adrianntz/gpstracker/Host Software/Host Website/assets/img/demo-image-01.png

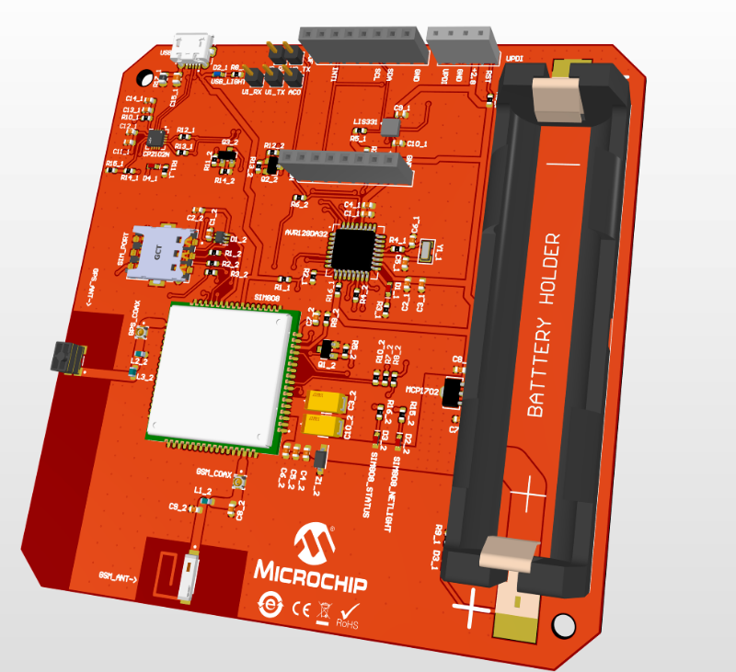
Host Software/Host Website/assets/img/demo-image-01.png
