adrianntz/gpstracker/Hardware/Readme.md

# Power Efficient GPS Tracker HW Design



This is an internship project aiming to build a portable GPS Tracker which sends out its GPS coordinates whenever it detects motion either through SMS or to a website application through power efficient means.
## Folders
- Design - Files for the Altium PCB Project for the GPS Tracker. Contains schematics, PCBDocs, Project output files.
- Manufacturing - Manufacturing files for PCB Factory.

## 3D View
### MCU+ACCEL SCHEMATIC
MCU+ACCEL SCHEMATIC
### SIM808 + RF SCHEMATIC

### TOP VIEW

### Bottom View

## Components used
````
1 AVR128DA32  
1 SIM808
1 MCP1702T
1 LIS331DLHTR
1 CP2102N 
1 MicroUSB
1 Li-Ion 2200mAh 3.6V 
1 Battery Holder

4 Red LED 0603 
1 Blue LED 0603
1 Green LED 0603 

6 R 4.7k 0603
3 R 47k 0603
1 R 47.5k 0603
2 R 5.6k 0603
5 R 0ohm 0603
8 R 220R 0603 
3 R 22R 0603
1 R 220k 0603
1 R 470k 0603
1 R 22.1k 0603
1 R 1k 0603
1 R 1M 0603 

6 Cap 0.1uF 0603
4 Cap 1uF 0603 
3 Cap 4.7uF 0603 
1 Cap 2.2uF 0603
1 Cap 10uF 0603
2 Cap 100uF Tantulum
1 Cap 22pF 0603
1 Cap 33pF 0603
1 Cap 13pF 0603
1 Cap 3.9pF 0603
2 Cap 10pF 0603
1 Cap 0.3pF 0603
1 Cap 100pF 0603

2 Ind 18nH 0603
1 Ind 5.1nH 0603 

3 MOSFET SOT-23-3

1 Zener 5.1V SOD-123

1 TVS Diode Array 5 channel

1 Nano SIM card holder

1 GSM Antenna
1 GPS Antenna 
2 Coaxial SMD Connectors 

````
