adrianntz/gpstracker/Firmware/Prototype Firmware/GPS_TRACKER_SW_architecture.png

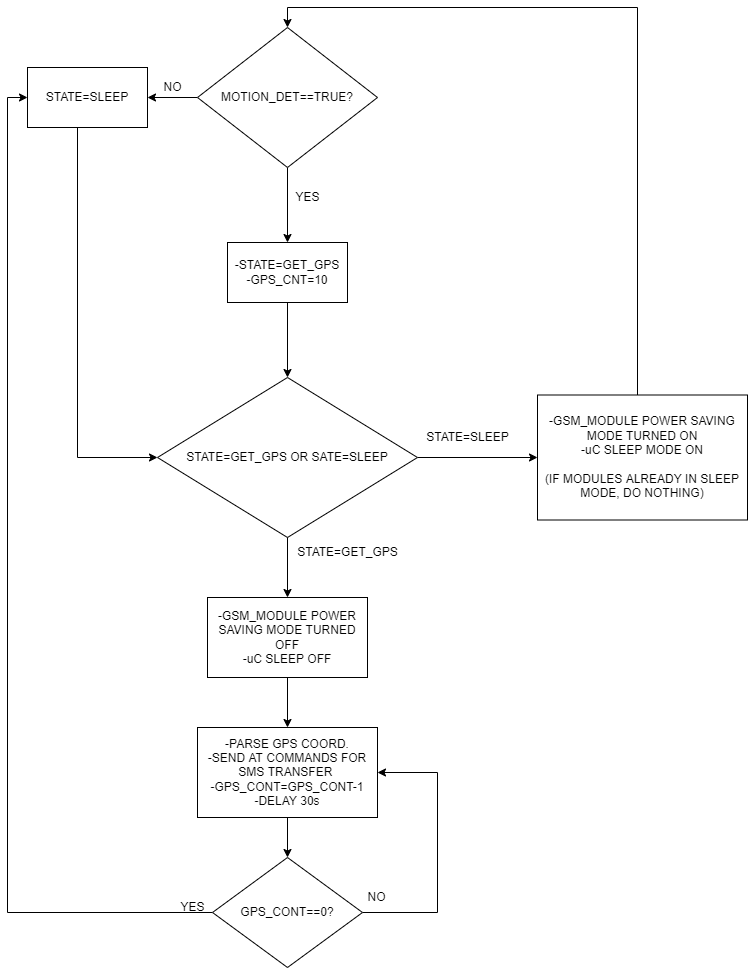
Firmware/Prototype Firmware/GPS_TRACKER_SW_architecture.png
