adrianntz/gpstracker/Hardware/GPS_TRACKER_HW_PROTOTYPE.png

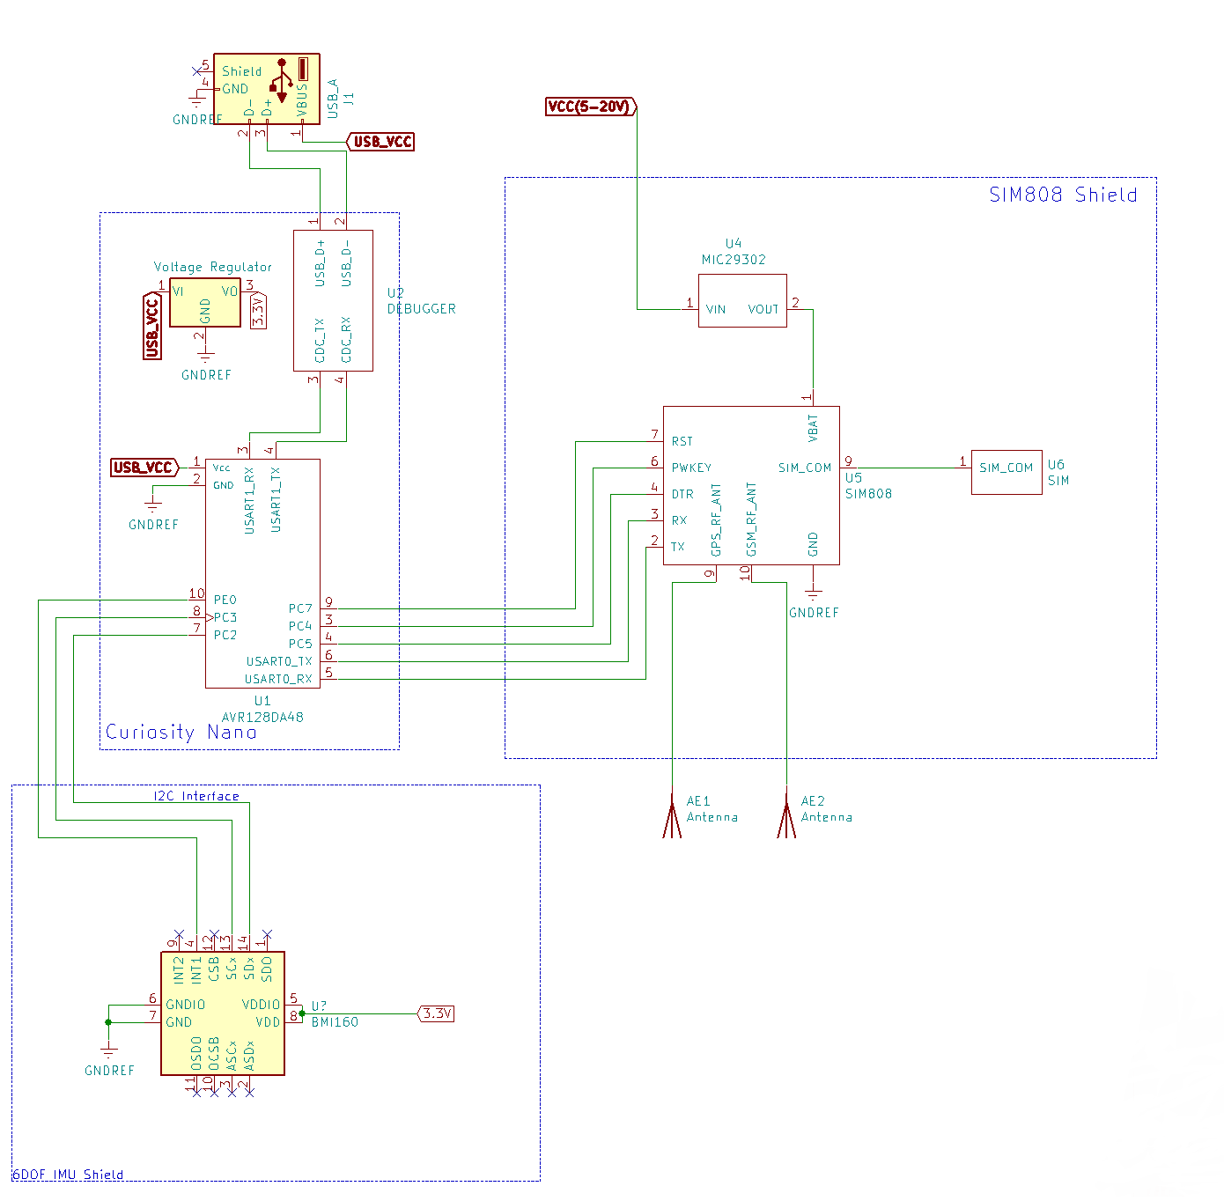
Hardware/GPS_TRACKER_HW_PROTOTYPE.png
