adrianntz/gpstracker/Host Software/Host Website/assets/img/demo-image-02.png

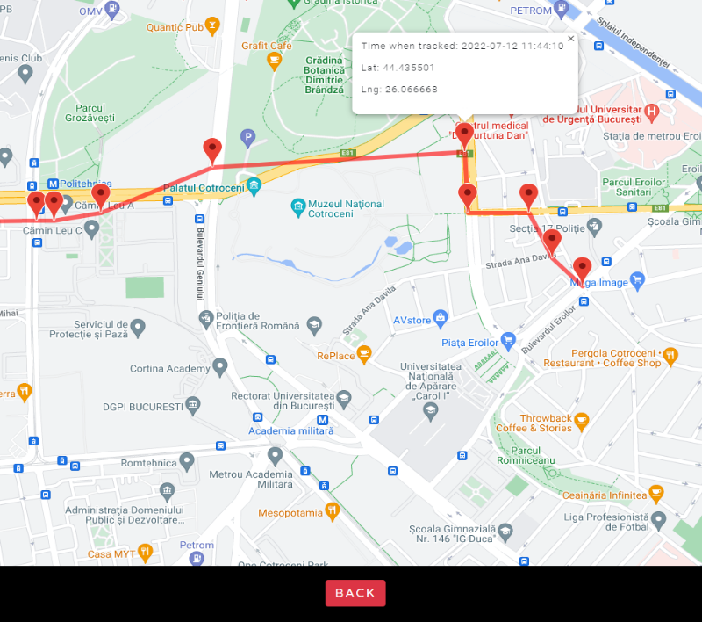
Host Software/Host Website/assets/img/demo-image-02.png
