adrianntz/gpstracker/Hardware/Design/Project Outputs for GPS_TRACKER/GPS_TRACKER_BOM.xlsx

Name | Description | Designator | Value | Quantity | Cantiate Cumparata
Transistor MOS-N GSD | Transistor MOS | Q1_2, Q2_2, Q3_2 | 2N7002-7-F | 3 | 30 | G
TAJC107K010RNJ | 100uF 10V ±10% 1.2Ω 2312 SMD Tantalum Capacitor | C3_2 | 100uF | 1 | 10 | G
SMF05CT1G | 5-Line Transient Voltage Suppressor Array, 6-Pin SC70, Pb-Free, Tape and Reel | U1_2 |  | 1 | 10 | G
SIM8051-6-0-14-01-A | NANO SIM PUSH PULL, 6P, SMT, 1.3 | J1_2 |  | 1 | 10 | G
Resistor | Resistor | R1_1 | 220k | 1 | 10 | G
Resistor | Resistor | R1_2, R2_2, R3_2 | 22R | 3 | 30 | G
Resistor | Resistor | R2_1 | 470k | 1 | 10 | G
Resistor | Resistor | R3_1, R8_1, R9_1, R11_1, R12_1, R13_1, R15_2, R16_2 | 220R | 8 | 80 | G
Resistor | Resistor | R4_1, R6_2, R7_2, R8_2 | 0R | 4 | 40 | G
Resistor | Resistor | R4_2, R11_2, R12_2,R5_1, R6_1, R7_1 | 4.7k | 6 | 60 | G
Resistor | Resistor | R5_2, R13_2, R14_2 | 47k | 3 | 30 | G
Resistor | Resistor | R9_2, R10_2 | 5.6k | 2 | 20 | G
Resistor | Resistor | R10_1 | 1k | 1 | 10 | G
MM8030-2610RJ3 | CONN SWG RCPT STR 50 OHM SMD | J2_2, J3_2 |  | 2 | 20 | G
MCP170X SOT-89-3_TO-92-3 | LDO | U3_1 | MCP1702/2.8V | 1 | 10 | G
LQW15AN5N9C10D | Wire Wound RF Inductor 5.9nH ±0.2nH 760mA 0.056Ω 0402 (1005) | L3_2 | 5.9nH | 1 | 10 | G
LIS331DLHTR | MEMS motion sensor: Ultra low power high performance 3-axis nano accelerometer, -40 to +85°C, LGA-16 (3x3x1), Tape and Reel | U4_1 |  | 1 | 10 | G
LED_red | LED | D1_1, D2_2, D3_2, D4_1 | RED | 4 | 40 | G
LED_green_true | LED TRUE GREEN | D3_1 |  | 1 | 10 | G
LED_blue | LED | D2_1 | BLUE | 1 | 10 | G
Inductor | Inductor | L1_2, L2_2 | 18nH | 2 | 20 | G
Header 1x8 | Header 1x8 | J3_1, J4_1 | HDR-1.27 Female 1x8 | 2 | 20
Header 1x4 |  | J2_1 | HDR-2.54 Female 1x4 | 1 | 10
GSM808 | Integrated Circuit | IC1_2 |  | 1 | 10 | G
Diode Zener |  | D1_2 | 5.1V | 1 | 10 | G
Crystal 2 Pins | Crystal | Y1_1 | 32.768KHZ | 1 | 10 | G
CP2102N-A02-GQFN20 | IC USB TO UART BRIDGE QFN20 | U5_1 |  | 1 | 10 | G
Capacitor NP |  | C1_1 | 2.2uF | 1 | 10 | G
Capacitor NP |  | C1_2 | 22pF | 1 | 10 | G
Capacitor NP |  | C2_1, C3_1, C4_1, C10_1, C12_1, C14_1 | 0.1uF | 6 | 60 | G
Capacitor NP |  | C2_2, C4_2, C7_1, C8_1 | 1uF | 4 | 40 | G
Capacitor NP |  | C5_1,C6_2 | 10pF | 2 | 20 | G
Capacitor NP |  | C5_2 | 33pF | 1 | 10 | G
Capacitor NP |  | C6_1 | 13pF | 1 | 10 | G
Capacitor NP |  | C7_2, C11_1, C13_1 | 4.7uF | 3 | 30 | G
Capacitor NP |  | C8_2 | 3.9pF | 1 | 10 | G
Capacitor NP |  | C9_1 | 10uF | 1 | 10 | G
Capacitor NP |  | C9_2 | 0.3pF | 1 | 10 | G
Battery Holder - 1042 | Undefined or Miscellaneous | U1_1 |  | 1 | 10 | G
AVR64DD32-I/PT |  | U2_1 | AVR64DD32 | 1 | 10 | G
1462350001 | RF ANT 1.575GHZ MOLDED SLDR SMD | ANT2_2 |  | 1 | 10 | G
105017-0001 | Micro-USB B Receptacle, Right Angle, Bottom Mount, Surface Mount, with Solder Tabs, -30 to 85 degC, 5-Pin USB, RoHS, Tape and Reel | J1_1 |  | 1 | 10 | G
0900AT43A0070E | RF ANT CHIP SOLDER SMD | ANT1_2 |  | 1 | 10 | G
