adrianntz/gpstracker/Hardware/Design/Project_Outputs/DevTools/ProjectPartNumber-RProjectRevisionSCH_FRM-50207.xlsx

Sheet: Revision History
Product Compliance Data Collection Tool
REV | DATE | CN # | ORIGINATOR | DESCRIPTION OF CHANGE
A | 2019-07-12 | FRM032985 | M.Wittel | Initial Release
B | 2020-12-11 | FRM049453 | B. Yncera | Name change of the "Compliance Review" worksheet to Development Boards_Modules. Addition of Product Compliance Description Worksheet Worksheet update to create more uniformity between the worksheets "SIP discrete components" and "Development Boards_Modules". Changes include: Cell text change J-Q Row 2 - "SIP discrete components" and "Development Boards_Modules" - "Product Compliance will complete" to "Product Compliance" (Vendor Part Number) columns "SIP discrete components" and "Development Boards_Modules" worksheets Removal of Column headers Pkg Size, Value 1, Value Tol, Value Uom 1, Value 2, Value Uom 2, RoHS 3 (Yes/No), from "SIP discrete components" and "Development Boards_Modules" worksheets Column header name change - REACH (SVHC) (Yes/No) 191 to REACH Conformant (Yes/No) "SIP discrete components" worksheet Column header name change - REACH (SVHC) (Yes/No) 197 to REACH Conformant (Yes/No) "Development Boards_Modules" worksheet. Addition of Column header - China RoHS (Affected/Unaffected) - "SIP discrete components" worksheet Column header name change - China RoHS Table Declaration Required (Yes/No) to China RoHS (Affected/Unaffected) "Development Boards_Modules" worksheet.
Electronic Distribution: SPS_16A, SPS_B, SPS_19
THIS DOCUMENT IS UNCONTROLLED UNLESS OTHERWISE STAMPED. It is the user’s responsibility to ensure this is the latest revision prior to using or referencing this document. |  |  |  |  | Page | Spec. No. | Rev.
© Microchip Technology Inc. |  |  |  |  | 1 | FRM-50207 | B

Sheet: Description
 | Any Worksheet within this spreadsheet can be modified as needed to collect information
 | Page quick link | Description
1 | FC LF Package | Single and Multi-Die, Flip Chip Interconnect in Leadframe Package
2 | FC Substrate Package | Single and Multi-Die, Flip Chip Interconnect in Substrate Package
3 | Hybrid LF Package | Multi-Die, Flip Chip and WB Interconnect in Leadframe Package
4 | Hybrid Substrate Package | Multi-Die, Flip Chip and WB Interconnect in Substrate Package
5 | WB LF Package | Single and Multi-Die, WB Interconnect in Leadframe Package
6 | WB Substrate Package | Single and Multi-Die, WB Interconnect in Substrate Package
7 | WLCSP | Wafer Level CSP
8 | SiP | Single and Multi-Die, Flip Chip or WB Interconnect with Passives/Active Components
9 | SIP discrete components | SIP discrete components Compliance Review
10 | MCD Example | MCD Example
11 | MCD Input Form | MCD Input Form
 | Development Boards_Modules | All Module or Board Level Compliance Review
12 | Product Compliance Description | Product Compliance Column Description
 | Note: If there are additional items (e.g. die conformal coat materials or more than one die attach materials), insert rows as required.

Sheet: FC LF Package
Assembly location:
Total Assembled weight: |  | Enter Value | Estimated Homogenous material weight (mg) | RoHS Test Report or CoC | MSDS Report or 100% MCD | Halogen-Free: IEC 61249-2-21:2003: Bromine (Br) ≤ 900 and Chlorine (Cl) ≤ 900 ppm by homogeneous material weight. With total Bromine (Br) plus Chlorine (Cl) content ≤ 1500 ppm by homogeneous material weight. (ICP) | EU REACH Report all SVHC
Molding Compound | Type/ Brand Name: | Enter Value | Enter Value | Attach Supporting Documentation / Insert Object | Attach Supporting Documentation / Insert Object | Attach Supporting Documentation / Insert Object | Attach Supporting Documentation / Insert Object / for all SVHC
 | Supplier | Enter Value
 | Manufacturing Site Location | Enter Value
Underfill | Type/ Brand Name: | Enter Value | Enter Value | Attach Supporting Documentation / Insert Object | Attach Supporting Documentation / Insert Object | Attach Supporting Documentation / Insert Object | Attach Supporting Documentation / Insert Object / for all SVHC
 | Supplier | Enter Value
 | Manufacturing Site Location | Enter Value
Lead frame information | Material Type/Brand Name: | Enter Value | Enter Value | Attach Supporting Documentation / Insert Object | Attach Supporting Documentation / Insert Object | N/A | Attach Supporting Documentation / Insert Object
 | Supplier | Enter Value
 | Manufacturing Site Location | Enter Value
 | Paddle Size | Enter Value
 | Part number | Enter Value
 | Process (Stamped / Etched) | Enter Value
 | Surface | Enter Value
 | Leadlock (Yes / No) | Enter Value
Flux | Type/ Brand Name: | Enter Value | Enter Value | Attach Supporting Documentation / Insert Object | Attach Supporting Documentation / Insert Object | Attach Supporting Documentation / Insert Object | Attach Supporting Documentation / Insert Object / for all SVHC
 | Supplier | Enter Value
 | Manufacturing Site Location | Enter Value
Plated Bump/Copper Pillar | Type/ Brand Name: | Enter Value | Enter Value | Attach Supporting Documentation / Insert Object | Attach Supporting Documentation / Insert Object | N/A | Attach Supporting Documentation / Insert Object / for all SVHC
 | Supplier: | Enter Value
 | Manufacturing Site Location | Enter Value
Die/Wafer Type | Type/ Brand Name: | Enter Value | Enter Value | Attach Supporting Documentation / Insert Object / SGS Test Report | Attach Supporting Documentation / Insert Object | N/A | Attach Supporting Documentation / Insert Object
 | Supplier: | Enter Value
 | Part number | Enter Value
 | Manufacturing Site Location | Enter Value
Plating Line Environmental Compliance Docs and Impurity Control Chart/Plan
Attach Control Plan or Chart Here | Type of process: | Enter Value | Enter Value | Attach Supporting Documentation / Insert Object | Attach Supporting Documentation / Insert Object | Attach Supporting Documentation / Insert Object | Attach Supporting Documentation / Insert Object
 | Principle Chemcial Supplier: | Enter Value
 | Location | Enter Value
Marking | Material Description | Enter Value | Enter Value | Attach Supporting Documentation / Insert Object | Attach Supporting Documentation / Insert Object | Attach Supporting Documentation / Insert Object | Attach Supporting Documentation / Insert Object / for all SVHC
 | Supplier: | Enter Value
 | Manufacturing Site Location | Enter Value

Sheet: FC Substrate Package
Assembly location:
Total Assembled weight: |  | Enter Value | Estimated Homogenous material weight (mg) | RoHS Test Report or CoC | MSDS Report or 100% MCD | Halogen-Free: IEC 61249-2-21:2003: Bromine (Br) ≤ 900 and Chlorine (Cl) ≤ 900 ppm by homogeneous material weight. With total Bromine (Br) plus Chlorine (Cl) content ≤ 1500 ppm by homogeneous material weight. (ICP) | EU REACH Report all SVHC
Molding Compound | Type/ Brand Name: | Enter Value | Enter Value | Attach Supporting Documentation / Insert Object | Attach Supporting Documentation / Insert Object | Attach Supporting Documentation / Insert Object | Attach Supporting Documentation / Insert Object / for all SVHC
 | Supplier | Enter Value
 | Manufacturing Site Location | Enter Value
Underfill | Type/ Brand Name: | Enter Value | Enter Value | Attach Supporting Documentation / Insert Object | Attach Supporting Documentation / Insert Object | Attach Supporting Documentation / Insert Object | Attach Supporting Documentation / Insert Object / for all SVHC
 | Supplier | Enter Value
 | Manufacturing Site Location | Enter Value
Plated Bump/Copper Pillar | Type/ Brand Name: | Enter Value | Enter Value | Attach Supporting Documentation / Insert Object | Attach Supporting Documentation / Insert Object | N/A | Attach Supporting Documentation / Insert Object / for all SVHC
 | Supplier: | Enter Value
 | Manufacturing Site Location | Enter Value
Substrate | Core Material Type/Brand Name: | Enter Value | Enter Value | Attach Supporting Documentation / Insert Object | Attach Supporting Documentation / Insert Object | N/A | Attach Supporting Documentation / Insert Object
 | Supplier | Enter Value
 | Manufacturing Site Location | Enter Value
 | Pre-preg Material | Enter Value
 | Part number | Enter Value
 | Via Plug Material | Enter Value
 | Soldermask Material | Enter Value
Flux | Type/ Brand Name: | Enter Value | Enter Value | Attach Supporting Documentation / Insert Object | Attach Supporting Documentation / Insert Object | Attach Supporting Documentation / Insert Object | Attach Supporting Documentation / Insert Object / for all SVHC
 | Supplier | Enter Value
 | Manufacturing Site Location | Enter Value
Solder Ball | Type/ Brand Name: | Enter Value | Enter Value | Attach Supporting Documentation / Insert Object | Attach Supporting Documentation / Insert Object | N/A | Attach Supporting Documentation / Insert Object / for all SVHC
 | Supplier: | Enter Value
 | Manufacturing Site Location | Enter Value
Sodler Paste | Type/ Brand Name: | Enter Value | Enter Value | Attach Supporting Documentation / Insert Object | Attach Supporting Documentation / Insert Object | N/A | Attach Supporting Documentation / Insert Object / for all SVHC
 | Supplier: | Enter Value
 | Manufacturing Site Location | Enter Value
Die/Wafer Type | Type/ Brand Name: | Enter Value | Enter Value | Attach Supporting Documentation / Insert Object / SGS Test Report | Attach Supporting Documentation / Insert Object | N/A | Attach Supporting Documentation / Insert Object
 | Supplier: | Enter Value
 | Part number | Enter Value
 | Manufacturing Site Location | Enter Value
Plating Line Environmental Compliance Docs and Impurity Control Chart/Plan
Attach Control Plan or Chart Here | Type of process: | Enter Value | Enter Value | Attach Supporting Documentation / Insert Object | Attach Supporting Documentation / Insert Object | Attach Supporting Documentation / Insert Object | Attach Supporting Documentation / Insert Object
 | Principle Chemcial Supplier: | Enter Value
 | Location | Enter Value
Marking | Material Description | Enter Value | Enter Value | Attach Supporting Documentation / Insert Object | Attach Supporting Documentation / Insert Object | Attach Supporting Documentation / Insert Object | Attach Supporting Documentation / Insert Object / for all SVHC
 | Supplier: | Enter Value
 | Manufacturing Site Location | Enter Value

Sheet: Hybrid LF Package
Assembly location:
Total Assembled weight: |  | Enter Value | Estimated Homogenous material weight (mg) | RoHS Test Report or CoC | MSDS Report or 100% MCD | Halogen-Free: IEC 61249-2-21:2003: Bromine (Br) ≤ 900 and Chlorine (Cl) ≤ 900 ppm by homogeneous material weight. With total Bromine (Br) plus Chlorine (Cl) content ≤ 1500 ppm by homogeneous material weight. (ICP) | EU REACH Report all SVHC
Molding Compound | Type/ Brand Name: | Enter Value | Enter Value | Attach Supporting Documentation / Insert Object | Attach Supporting Documentation / Insert Object | Attach Supporting Documentation / Insert Object | Attach Supporting Documentation / Insert Object / for all SVHC
 | Supplier | Enter Value
 | Manufacturing Site Location | Enter Value
Die Attach Material | Type/ Brand Name: | Enter Value | Enter Value | Attach Supporting Documentation / Insert Object | Attach Supporting Documentation / Insert Object | Attach Supporting Documentation / Insert Object | Attach Supporting Documentation / Insert Object / for all SVHC
 | Supplier | Enter Value
 | Manufacturing Site Location | Enter Value
Underfill | Type/ Brand Name: | Enter Value | Enter Value | Attach Supporting Documentation / Insert Object | Attach Supporting Documentation / Insert Object | Attach Supporting Documentation / Insert Object | Attach Supporting Documentation / Insert Object / for all SVHC
 | Supplier | Enter Value
 | Manufacturing Site Location | Enter Value
LF | Material Type/Brand Name: | Enter Value | Enter Value | Attach Supporting Documentation / Insert Object | Attach Supporting Documentation / Insert Object | N/A | Attach Supporting Documentation / Insert Object
 | Supplier | Enter Value | Enter Value
 | Manufacturing Site Location | Enter Value | Enter Value
 | Paddle Size | Enter Value | Enter Value
 | Part number | Enter Value | Enter Value
 | Process (Stamped / Etched) | Enter Value | Enter Value
 | Surface | Enter Value | Enter Value
 | Leadlock (Yes / No) | Enter Value | Enter Value
Plated Bump/Copper Pillar | Type/ Brand Name: | Enter Value | Enter Value | Attach Supporting Documentation / Insert Object | Attach Supporting Documentation / Insert Object | N/A | Attach Supporting Documentation / Insert Object / for all SVHC
 | Supplier: | Enter Value
 | Manufacturing Site Location | Enter Value
Flux | Type/ Brand Name: | Enter Value | Enter Value | Attach Supporting Documentation / Insert Object | Attach Supporting Documentation / Insert Object | Attach Supporting Documentation / Insert Object | Attach Supporting Documentation / Insert Object / for all SVHC
 | Supplier | Enter Value
 | Manufacturing Site Location | Enter Value
Bond Wire | Type/ Brand Name: | Enter Value | Enter Value | Attach Supporting Documentation / Insert Object | Attach Supporting Documentation / Insert Object | N/A | Attach Supporting Documentation / Insert Object / for all SVHC
 | Supplier: | Enter Value
 | Manufacturing Site Location | Enter Value
Die/Wafer Type | Type/ Brand Name: | Enter Value | Enter Value | Attach Supporting Documentation / Insert Object / SGS Test Report | Attach Supporting Documentation / Insert Object | N/A | Attach Supporting Documentation / Insert Object
 | Supplier: | Enter Value
 | Part number | Enter Value
 | Manufacturing Site Location | Enter Value
Plating Line Environmental Compliance Docs and Impurity Control Chart/Plan
Attach Control Plan or Chart Here | Type of process: | Enter Value | Enter Value | Attach Supporting Documentation / Insert Object | Attach Supporting Documentation / Insert Object | Attach Supporting Documentation / Insert Object | Attach Supporting Documentation / Insert Object
 | Principle Chemcial Supplier: | Enter Value
 | Location | Enter Value
Marking | Material Description | Enter Value | Enter Value | Attach Supporting Documentation / Insert Object | Attach Supporting Documentation / Insert Object | Attach Supporting Documentation / Insert Object | Attach Supporting Documentation / Insert Object / for all SVHC
 | Supplier: | Enter Value
 | Manufacturing Site Location | Enter Value

Sheet: Hybrid Substrate Package
Assembly location:
Total Assembled weight: |  | Enter Value | Estimated Homogenous material weight (mg) | RoHS Test Report or CoC | MSDS Report or 100% MCD | Halogen-Free: IEC 61249-2-21:2003: Bromine (Br) ≤ 900 and Chlorine (Cl) ≤ 900 ppm by homogeneous material weight. With total Bromine (Br) plus Chlorine (Cl) content ≤ 1500 ppm by homogeneous material weight. (ICP) | EU REACH Report all SVHC
Molding Compound | Type/ Brand Name: | Enter Value | Enter Value | Attach Supporting Documentation / Insert Object | Attach Supporting Documentation / Insert Object | Attach Supporting Documentation / Insert Object | Attach Supporting Documentation / Insert Object / for all SVHC
 | Supplier | Enter Value
 | Manufacturing Site Location | Enter Value
Die film/Die attachment | Type/ Brand Name: | Enter Value | Enter Value | Attach Supporting Documentation / Insert Object | Attach Supporting Documentation / Insert Object | Attach Supporting Documentation / Insert Object | Attach Supporting Documentation / Insert Object / for all SVHC
 | Supplier | Enter Value
 | Manufacturing Site Location | Enter Value
Underfill | Type/ Brand Name: | Enter Value | Enter Value | Attach Supporting Documentation / Insert Object | Attach Supporting Documentation / Insert Object | Attach Supporting Documentation / Insert Object | Attach Supporting Documentation / Insert Object / for all SVHC
 | Supplier | Enter Value
 | Manufacturing Site Location | Enter Value
Flux | Type/ Brand Name: | Enter Value | Enter Value | Attach Supporting Documentation / Insert Object | Attach Supporting Documentation / Insert Object | Attach Supporting Documentation / Insert Object | Attach Supporting Documentation / Insert Object / for all SVHC
 | Supplier | Enter Value
 | Manufacturing Site Location | Enter Value
Substrate | Core Material Type/Brand Name: | Enter Value | Enter Value | Attach Supporting Documentation / Insert Object | Attach Supporting Documentation / Insert Object | N/A | Attach Supporting Documentation / Insert Object
 | Supplier | Enter Value
 | Manufacturing Site Location | Enter Value
 | Pre-preg Material | Enter Value
 | Part number | Enter Value
 | Via Plug Material | Enter Value
 | Soldermask Material | Enter Value
Plated Bump/Copper Pillar | Type/ Brand Name: | Enter Value | Enter Value | Attach Supporting Documentation / Insert Object | Attach Supporting Documentation / Insert Object | N/A | Attach Supporting Documentation / Insert Object / for all SVHC
 | Supplier: | Enter Value
 | Manufacturing Site Location | Enter Value
Bond Wire | Type/ Brand Name: | Enter Value | Enter Value | Attach Supporting Documentation / Insert Object | Attach Supporting Documentation / Insert Object | N/A | Attach Supporting Documentation / Insert Object / for all SVHC
 | Supplier: | Enter Value
 | Manufacturing Site Location | Enter Value
Solder Ball | Type/ Brand Name: | Enter Value | Enter Value | Attach Supporting Documentation / Insert Object | Attach Supporting Documentation / Insert Object | N/A | Attach Supporting Documentation / Insert Object / for all SVHC
 | Supplier: | Enter Value
 | Manufacturing Site Location | Enter Value
Sodler Paste | Type/ Brand Name: | Enter Value | Enter Value | Attach Supporting Documentation / Insert Object | Attach Supporting Documentation / Insert Object | N/A | Attach Supporting Documentation / Insert Object / for all SVHC
 | Supplier: | Enter Value
 | Manufacturing Site Location | Enter Value
Die/Wafer Type | Type/ Brand Name: | Enter Value | Enter Value | Attach Supporting Documentation / Insert Object / SGS Test Report | Attach Supporting Documentation / Insert Object | N/A | Attach Supporting Documentation / Insert Object
 | Supplier: | Enter Value
 | Part number | Enter Value
 | Manufacturing Site Location | Enter Value
Plating Line Environmental Compliance Docs and Impurity Control Chart/Plan
Attach Control Plan or Chart Here | Type of process: | Enter Value | Enter Value | Attach Supporting Documentation / Insert Object | Attach Supporting Documentation / Insert Object | Attach Supporting Documentation / Insert Object | Attach Supporting Documentation / Insert Object
 | Principle Chemcial Supplier: | Enter Value
 | Location | Enter Value
Marking | Material Description | Enter Value | Enter Value | Attach Supporting Documentation / Insert Object | Attach Supporting Documentation / Insert Object | Attach Supporting Documentation / Insert Object | Attach Supporting Documentation / Insert Object / for all SVHC
 | Supplier: | Enter Value
 | Manufacturing Site Location | Enter Value

Sheet: SiP
Assembly location:
Total Assembled weight: |  | Enter Value | Estimated Homogenous material weight (mg) | RoHS Test Report or CoC | MSDS Report or 100% MCD | Halogen-Free: IEC 61249-2-21:2003: Bromine (Br) ≤ 900 and Chlorine (Cl) ≤ 900 ppm by homogeneous material weight. With total Bromine (Br) plus Chlorine (Cl) content ≤ 1500 ppm by homogeneous material weight. (ICP) | EU REACH Report all SVHC
Molding Compound | Type/ Brand Name: | Enter Value | Enter Value | Attach Supporting Documentation / Insert Object | Attach Supporting Documentation / Insert Object | Attach Supporting Documentation / Insert Object | Attach Supporting Documentation / Insert Object / for all SVHC
 | Supplier | Enter Value
 | Manufacturing Site Location | Enter Value
Die Attach Material | Type/ Brand Name: | Enter Value | Enter Value | Attach Supporting Documentation / Insert Object | Attach Supporting Documentation / Insert Object | Attach Supporting Documentation / Insert Object | Attach Supporting Documentation / Insert Object / for all SVHC
 | Supplier | Enter Value
 | Manufacturing Site Location | Enter Value
Substrate | Core Material Type/Brand Name: | Enter Value | Enter Value | Attach Supporting Documentation / Insert Object | Attach Supporting Documentation / Insert Object | N/A | Attach Supporting Documentation / Insert Object
 | Supplier | Enter Value
 | Manufacturing Site Location | Enter Value
 | Pre-preg Material | Enter Value
 | Part number | Enter Value
 | Via Plug Material | Enter Value
 | Soldermask Material | Enter Value
Bond Wire | Type/ Brand Name: | Enter Value | Enter Value | Attach Supporting Documentation / Insert Object | Attach Supporting Documentation / Insert Object | N/A | Attach Supporting Documentation / Insert Object / for all SVHC
 | Supplier: | Enter Value
 | Manufacturing Site Location | Enter Value
Components | Type/ Brand Name: | Enter Value | Enter Value | Attach Supporting Documentation / Insert Object | Attach Supporting Documentation / Insert Object | N/A | Attach Supporting Documentation / Insert Object / for all SVHC
 | Supplier: | Enter Value
 | Manufacturing Site Location | Enter Value
Die/Wafer Type | Type/ Brand Name: | Enter Value | Enter Value | Attach Supporting Documentation / Insert Object / SGS Test Report | Attach Supporting Documentation / Insert Object | N/A | Attach Supporting Documentation / Insert Object
 | Supplier: | Enter Value
 | Part number | Enter Value
 | Manufacturing Site Location | Enter Value
Plating Line Environmental Compliance Docs and Impurity Control Chart/Plan
Attach Control Plan or Chart Here | Type of process: | Enter Value | Enter Value | Attach Supporting Documentation / Insert Object | Attach Supporting Documentation / Insert Object | Attach Supporting Documentation / Insert Object | Attach Supporting Documentation / Insert Object
 | Principle Chemcial Supplier: | Enter Value
 | Location | Enter Value
Marking | Material Description | Enter Value | Enter Value | Attach Supporting Documentation / Insert Object | Attach Supporting Documentation / Insert Object | Attach Supporting Documentation / Insert Object | Attach Supporting Documentation / Insert Object / for all SVHC
 | Supplier: | Enter Value
 | Manufacturing Site Location | Enter Value

Sheet: SIP discrete components
RoHS Yes/No | Package Code | Catalog Part Number | Assembly Site | * = Mandatory Field
 |  |  |  |  |  |  |  |  | Product Compliance
Reference Designator | Microchip Description | Material | Primary Component Yes / No | Supplier Name (Vendor Name) | Supplier Part Number (Vendor Part Number) | *Manufacturer | *Manufacturer Part Number | *Manufacturer Description | RoHS 3 (Yes/No) | RoHS Exemption (Value) | REACH Conformant (Yes/No) | Halogen Free (Yes/No) | FMD Available (Yes/No) | Weight (mg) | China RoHS (Affected/Unaffected) | Notes / Comments

Sheet: WB LF Package
RoHS Yes/No
Total Assembled weight: |  | Enter Value | Estimated Homogenous material weight (mg) | RoHS Test Report or CoC | MSDS Report or 100% MCD | Halogen-Free: IEC 61249-2-21:2003: Bromine (Br) ≤ 900 and Chlorine (Cl) ≤ 900 ppm by homogeneous material weight. With total Bromine (Br) plus Chlorine (Cl) content ≤ 1500 ppm by homogeneous material weight. (ICP) | EU REACH Report all SVHC
Molding Compound | Type/ Brand Name: | Enter Value | Enter Value | Attach Supporting Documentation / Insert Object | Attach Supporting Documentation / Insert Object | Attach Supporting Documentation / Insert Object | Attach Supporting Documentation / Insert Object / for all SVHC
 | Supplier | Enter Value
 | Manufacturing Site Location | Enter Value
Die Attach Material | Type/ Brand Name: | Enter Value | Enter Value | Attach Supporting Documentation / Insert Object | Attach Supporting Documentation / Insert Object | Attach Supporting Documentation / Insert Object | Attach Supporting Documentation / Insert Object / for all SVHC
 | Supplier | Enter Value
 | Manufacturing Site Location | Enter Value
Lead frame information | Material Type/Brand Name: | Enter Value | Enter Value | Attach Supporting Documentation / Insert Object | Attach Supporting Documentation / Insert Object | N/A | Attach Supporting Documentation / Insert Object
 | Supplier | Enter Value
 | Manufacturing Site Location | Enter Value
 | Paddle Size | Enter Value
 | Part number | Enter Value
 | Process (Stamped / Etched) | Enter Value
 | Surface | Enter Value
 | Leadlock (Yes / No) | Enter Value
Bond Wire | Type/ Brand Name: | Enter Value | Enter Value | Attach Supporting Documentation / Insert Object | Attach Supporting Documentation / Insert Object | N/A | Attach Supporting Documentation / Insert Object / for all SVHC
 | Supplier: | Enter Value
 | Manufacturing Site Location | Enter Value
Die/Wafer Type | Type/ Brand Name: | Enter Value | Enter Value | Attach Supporting Documentation / Insert Object / SGS Test Report | Attach Supporting Documentation / Insert Object | N/A | Attach Supporting Documentation / Insert Object
 | Supplier: | Enter Value
 | Part number | Enter Value
 | Manufacturing Site Location | Enter Value
Plating Line Environmental Compliance Docs and Impurity Control Chart/Plan
Attach Control Plan or Chart Here | Type of process: | Enter Value | Enter Value | Attach Supporting Documentation / Insert Object | Attach Supporting Documentation / Insert Object | Attach Supporting Documentation / Insert Object | Attach Supporting Documentation / Insert Object
 | Principle Chemcial Supplier: | Enter Value
 | Location | Enter Value
Marking | Material Description | Enter Value | Enter Value | Attach Supporting Documentation / Insert Object | Attach Supporting Documentation / Insert Object | Attach Supporting Documentation / Insert Object | Attach Supporting Documentation / Insert Object / for all SVHC
 | Supplier: | Enter Value
 | Manufacturing Site Location | Enter Value

Sheet: WB Substrate Package
RoHS Yes/No
Total Assembled weight: |  | Enter Value | Estimated Homogenous material weight (mg) | RoHS Test Report or CoC | MSDS Report or 100% MCD | Halogen-Free: IEC 61249-2-21:2003: Bromine (Br) ≤ 900 and Chlorine (Cl) ≤ 900 ppm by homogeneous material weight. With total Bromine (Br) plus Chlorine (Cl) content ≤ 1500 ppm by homogeneous material weight. (ICP) | EU REACH Report all SVHC
Molding Compound | Type/ Brand Name: | Enter Value | Enter Value | Attach Supporting Documentation / Insert Object | Attach Supporting Documentation / Insert Object | Attach Supporting Documentation / Insert Object | Attach Supporting Documentation / Insert Object / for all SVHC
 | Supplier | Enter Value
 | Manufacturing Site Location | Enter Value
Die Attach Material | Type/ Brand Name: | Enter Value | Enter Value | Attach Supporting Documentation / Insert Object | Attach Supporting Documentation / Insert Object | Attach Supporting Documentation / Insert Object | Attach Supporting Documentation / Insert Object / for all SVHC
 | Supplier | Enter Value
 | Manufacturing Site Location | Enter Value
Substrate | Core Material Type/Brand Name: | Enter Value | Enter Value | Attach Supporting Documentation / Insert Object | Attach Supporting Documentation / Insert Object | N/A | Attach Supporting Documentation / Insert Object
 | Supplier | Enter Value
 | Manufacturing Site Location | Enter Value
 | Pre-preg Material | Enter Value
 | Part number | Enter Value
 | Via Plug Material | Enter Value
 | Soldermask Material | Enter Value
Bond Wire | Type/ Brand Name: | Enter Value | Enter Value | Attach Supporting Documentation / Insert Object | Attach Supporting Documentation / Insert Object | N/A | Attach Supporting Documentation / Insert Object / for all SVHC
 | Supplier: | Enter Value
 | Manufacturing Site Location | Enter Value
Solder Ball | Type/ Brand Name: | Enter Value | Enter Value | Attach Supporting Documentation / Insert Object | Attach Supporting Documentation / Insert Object | N/A | Attach Supporting Documentation / Insert Object / for all SVHC
 | Supplier: | Enter Value
 | Manufacturing Site Location | Enter Value
Sodler Paste | Type/ Brand Name: | Enter Value | Enter Value | Attach Supporting Documentation / Insert Object | Attach Supporting Documentation / Insert Object | N/A | Attach Supporting Documentation / Insert Object / for all SVHC
 | Supplier: | Enter Value
 | Manufacturing Site Location | Enter Value
Die/Wafer Type | Type/ Brand Name: | Enter Value | Enter Value | Attach Supporting Documentation / Insert Object / SGS Test Report | Attach Supporting Documentation / Insert Object | N/A | Attach Supporting Documentation / Insert Object
 | Supplier: | Enter Value
 | Part number | Enter Value
 | Manufacturing Site Location | Enter Value
Plating Line Environmental Compliance Docs and Impurity Control Chart/Plan
Attach Control Plan or Chart Here | Type of process: | Enter Value | Enter Value | Attach Supporting Documentation / Insert Object | Attach Supporting Documentation / Insert Object | Attach Supporting Documentation / Insert Object | Attach Supporting Documentation / Insert Object
 | Principle Chemcial Supplier: | Enter Value
 | Location | Enter Value
Marking | Material Description | Enter Value | Enter Value | Attach Supporting Documentation / Insert Object | Attach Supporting Documentation / Insert Object | Attach Supporting Documentation / Insert Object | Attach Supporting Documentation / Insert Object / for all SVHC
 | Supplier: | Enter Value
 | Manufacturing Site Location | Enter Value

Sheet: WLCSP
RoHS Yes/No
Total Assembled weight: |  | Enter Value | Estimated Homogenous material weight (mg) | RoHS Test Report or CoC | MSDS Report or 100% MCD | Halogen-Free: IEC 61249-2-21:2003: Bromine (Br) ≤ 900 and Chlorine (Cl) ≤ 900 ppm by homogeneous material weight. With total Bromine (Br) plus Chlorine (Cl) content ≤ 1500 ppm by homogeneous material weight. (ICP) | EU REACH Report all SVHC
Solder Ball Attach/Flux | Material Type/ Brand Name: | Enter Value | Enter Value | Attach Supporting Documentation / Insert Object | Attach Supporting Documentation / Insert Object | Attach Supporting Documentation / Insert Object | Attach Supporting Documentation / Insert Object / for all SVHC
 | Supplier | Enter Value
 | Manufacturing Site Location | Enter Value
Backside Laminate/Coating | Material Type/Brand Name: | Enter Value | Enter Value | Attach Supporting Documentation / Insert Object | Attach Supporting Documentation / Insert Object | N/A | Attach Supporting Documentation / Insert Object
WLCSP Materials | PI/PBO Material | Enter Value |  | Attach Supporting Documentation / Insert Object | Attach Supporting Documentation / Insert Object | N/A | Attach Supporting Documentation / Insert Object
 | RDL | Enter Value
 | UBM | Enter Value
Solder Ball/Alloy | Type/ Brand Name: | Enter Value | Enter Value | Attach Supporting Documentation / Insert Object | Attach Supporting Documentation / Insert Object | N/A | Attach Supporting Documentation / Insert Object / for all SVHC
 | Supplier: | Enter Value
 | Manufacturing Site Location | Enter Value
Die/Wafer Type | Type/ Brand Name: | Enter Value | Enter Value | Attach Supporting Documentation / Insert Object / SGS Test Report | Attach Supporting Documentation / Insert Object | N/A | Attach Supporting Documentation / Insert Object
 | Supplier: | Enter Value
 | Part number | Enter Value
 | Manufacturing Site Location | Enter Value
Plating Line Environmental Compliance Docs and Impurity Control Chart/Plan
Attach Control Plan or Chart Here | Type of process: | Enter Value | Enter Value | Attach Supporting Documentation / Insert Object | Attach Supporting Documentation / Insert Object | Attach Supporting Documentation / Insert Object | Attach Supporting Documentation / Insert Object
 | Principle Chemcial Supplier: | Enter Value
 | Location | Enter Value
Marking | Material Description | Enter Value | Enter Value | Attach Supporting Documentation / Insert Object | Attach Supporting Documentation / Insert Object | Attach Supporting Documentation / Insert Object | Attach Supporting Documentation / Insert Object / for all SVHC
 | Supplier: | Enter Value
 | Manufacturing Site Location | Enter Value

Sheet: MCD Example
RoHS Yes/No
(Example) Material Composition Declaration Sheet <MCD>
Company Name : ________________
Package Type :_______________ ( Example : SOIE3 )
MCHP Package Code : _______________ ( Example : C2 ) |  |  |  | (Note : MCHP is Microchip)
Package Type : _____________________ ( Example : 8L SOIC )
No. | Material Name | Material Type/Grade | Manufacturer | Material Weight (mg) | Material Percentage (%) | Chemical Ingredient | CAS No. | % Chemical in Material | % Chemical in Product | Chemical Mass in Product (mg) | PPM
1 | Die | Silicon Chip | AAAAA | 2.40 | 0.22 | Silicon (Si) | 7440-21-3 | 100 | 0.2232558 | 2.400000 | 2232.558
2 | Leadframe | Copper Alloy (C_ _ _) | BBBBB | 22.31 | 2.08 | Copper (Cu) | 7440-50-8 | 97.798 | 2.0296497 | 21.818734 | 20296.497
 |  |  |  |  |  | Iron (Fe) | 7439-89-6 | 2.052 | 0.0425862 | 0.457801 | 425.862
 |  |  |  |  |  | Phosphorus (P) | 7723-14-0 | 0.05 | 0.0010377 | 0.011155 | 10.377
 |  |  |  |  |  | Zinc (Zn) | 7440-66-6 | 0.1 | 0.0020753 | 0.022310 | 20.753
 |  | Silver Plating | CCCCC | 0.11 | 0.01 | Silver (Ag) | 7440-22-4 | 100 | 0.0102326 | 0.110000 | 102.326
 |  | Tape | DDDDD | 0.16 | 0.01 | Polyimide | 25038-81-7 | 43 | 0.0064000 | 0.068800 | 64.000
 |  | (on Leadframe) |  |  |  | Poly-ethylene-terephthalate | 25038-59-9 | 38 | 0.0056558 | 0.060800 | 56.558
 |  |  |  |  |  | NBR | 9003-18-3 | 7 | 0.0010419 | 0.011200 | 10.419
 |  |  |  |  |  | Bismaleimide | 79922-55-7 | 6 | 0.0008930 | 0.009600 | 8.930
 |  |  |  |  |  | Phenol resin | 28453-20-5 | 6 | 0.0008930 | 0.009600 | 8.930
3 | Die Attach Material | 8390A | EEEEE | 0.25 | 0.02 | Modified epoxy Resin | 13561-08-5 | 12 | 0.0027907 | 0.030000 | 27.907
 |  |  |  |  |  | Diglycidylether of bisphenol-F | 54208-63-8 | 8 | 0.0018605 | 0.020000 | 18.605
 |  |  |  |  |  | Modified Amine | 827-43-0 | 5 | 0.0011628 | 0.012500 | 11.628
 |  |  |  |  |  | Silver (Ag) | 7440-22-4 | 75 | 0.0174419 | 0.187500 | 174.419
4 | Bonding Wire | Gold Wire | FFFFF | 0.70 | 0.07 | Gold (Au) | 7440-57-5 | 99.993 | 0.0651117 | 0.699951 | 651.117
 |  |  |  |  |  | Silver (Ag) | 7440-22-4 | 0.003 | 0.0000020 | 0.000021 | 0.020
 |  |  |  |  |  | Beryllium (Be) | 7440-41-7 | 0.001 | 0.0000007 | 0.000007 | 0.007
 |  |  |  |  |  | Calcium (Ca) | 7440-70-2 | 0.003 | 0.0000020 | 0.000021 | 0.020
5 | Molding Compound | Epoxy Resin | GGGGG | 1047.17 | 97.41 | Fused Silica | 60676-86-0 | 67.2 | 65.4603014 | 703.698240 | 654603.014
 | (Encapsulation) | (Grade : EME-XXXX) |  |  |  | Epoxy, Cresol Novolac | 29690-82-2 | 20 | 19.4822326 | 209.434000 | 194822.326
 |  |  |  |  |  | Phenol Novolac | 9003-35-4 | 7.5 | 7.3058372 | 78.537750 | 73058.372
 |  |  |  |  |  | Antimony Trioxide | 1309-64-4 | 3 | 2.9223349 | 31.415100 | 29223.349
 |  |  |  |  |  | Brominated Epoxy Resin | 40039-93-8 | 2 | 1.9482233 | 20.943400 | 19482.233
 |  |  |  |  |  | Carbon Black | 1333-86-4 | 0.3 | 0.2922335 | 3.141510 | 2922.335
6 | Lead Finish Plating | SnPb (85/15) | HHHHH | 1.90 | 0.18 | Tin (Sn) | 7440-31-5 | 85 | 0.1502326 | 1.615000 | 1502.326
 |  |  |  |  |  | Lead (Pb) | 7439-92-1 | 15 | 0.0265116 | 0.285000 | 265.116
 | Total |  |  | 1075.00 | 100.00 |  |  |  | 100.00 | 1075.00 | 1000000.00
 |  |  |  | (PKG Weight)

Sheet: MCD Input Form
RoHS Yes/No
Material Composition Declaration Sheet <MCD>
Company Name : ________________
Package Type : _______________
MCHP Package Code :
Package Type : _____________________
No. | Material Name | Material Type/Grade | Manufacturer | Material Weight (mg) | Material Percentage (%) | Chemical Ingredient | CAS No. | % Chemical in Material | % Chemical in Product | Chemical Mass in Product (mg) | PPM
1 | Die |  |  |  | #DIV/0! |  |  |  | #DIV/0! | 0.000000 | #DIV/0!
2 | Leadframe/Substrate |  |  |  | #DIV/0! |  |  |  | #DIV/0! | 0.000000 | #DIV/0!
 |  |  |  |  |  |  |  |  | #DIV/0! | 0.000000 | #DIV/0!
 |  |  |  |  |  |  |  |  | #DIV/0! | 0.000000 | #DIV/0!
 |  |  |  |  |  |  |  |  | #DIV/0! | 0.000000 | #DIV/0!
3 | Die Attach Material |  |  |  | #DIV/0! |  |  |  | #DIV/0! | 0.000000 | #DIV/0!
 |  |  |  |  |  |  |  |  | #DIV/0! | 0.000000 | #DIV/0!
 |  |  |  |  |  |  |  |  | #DIV/0! | 0.000000 | #DIV/0!
 |  |  |  |  |  |  |  |  | #DIV/0! | 0.000000 | #DIV/0!
4 | Bonding Wire/Bump |  |  |  | #DIV/0! |  |  |  | #DIV/0! | 0.000000 | #DIV/0!
 |  |  |  |  |  |  |  |  | #DIV/0! | 0.000000 | #DIV/0!
 |  |  |  |  |  |  |  |  | #DIV/0! | 0.000000 | #DIV/0!
 |  |  |  |  |  |  |  |  | #DIV/0! | 0.000000 | #DIV/0!
5 | Molding Compound |  |  |  | #DIV/0! |  |  |  | #DIV/0! | 0.000000 | #DIV/0!
 | (Encapsulation) |  |  |  |  |  |  |  | #DIV/0! | 0.000000 | #DIV/0!
 |  |  |  |  |  |  |  |  | #DIV/0! | 0.000000 | #DIV/0!
 |  |  |  |  |  |  |  |  | #DIV/0! | 0.000000 | #DIV/0!
 |  |  |  |  |  |  |  |  | #DIV/0! | 0.000000 | #DIV/0!
 |  |  |  |  |  |  |  |  | #DIV/0! | 0.000000 | #DIV/0!
6 | Lead Finish Plating/BGA |  |  |  | #DIV/0! |  |  |  | #DIV/0! | 0.000000 | #DIV/0!
 |  |  |  |  |  |  |  |  | #DIV/0! | 0.000000 | #DIV/0!
 | Total |  |  | 0.00 | #DIV/0! |  |  |  | #DIV/0! | 0.00 | #DIV/0!
 |  |  |  | (PKG Weight)

Sheet: Development Boards_Modules
PN | <Parameter ProjectPartNumber not found> |  |  | REV | <Parameter ProjectRevisionSCH not found> | TITLE | <Parameter ProjectTitle not found>
 |  |  |  |  |  |  |  |  | Product Compliance
Designator | MCHP-ID | Material | *Primary Component Yes / No | Supplier 1 | Supplier Part Number 1 | Manufacturer 1 | Manufacturer Part Number 1 | Description_ | RoHS 3 (Yes/No) | RoHS Exemption (Value) | REACH Conformant (Yes/No) | REACH VERSION | Halogen Free (Yes/No) | FMD Available (Yes/No) | Weight (mg) | China RoHS (Affected/Unaffected) | Notes / Comments | Populated | Fitted
ANT1_2, ANT2_2, C3_2, C10_2, D1_2, IC1_2, J1_2, J2_2, J3_2, U1_1, U4_1, U5_1, USB, Z1_2 |  |  | YES |  |  |  |  |  |  |  |  |  |  |  |  |  |  |  | Fitted
AVR128DA32 | MIC9190 |  | YES | Microchip Technology | AVR64DD32-I/PT | Microchip Technology | AVR64DD32-I/PT | MCHP MCU 8-bit 24MHz 64KB 8KB AVR64DD32-I/PT TQFP-32 |  |  |  |  |  |  |  |  |  | YES | Fitted
C1_1 | CAP0597 |  | YES | Digi-Key | 445-5157-1-ND | TDK Corporation | C1608X5R1C225K080AB | CAP CER 2.2uF 16V 10% X5R SMD 0603 |  |  |  |  |  |  |  |  |  | Yes | Fitted
C1_2 | CAP0074 |  | YES | Cal-Chip | GMC10CG220J50NTLF | Cal-Chip | GMC10CG220J50NTLF | CAP CER 22pF 50V 5% NP0 SMD 0603 |  |  |  |  |  |  |  |  |  | Yes | Fitted
C2_1, C3_1, C4_1, C10_1, C12_1, C14_1 | CAP0011 |  | YES | Newark | 86H5248 | Taiyo Yuden | EMK107B7104KA-T | CAP CER 0.1uF 16V 10% X7R SMD 0603 |  |  |  |  |  |  |  |  |  | YES | Fitted
C2_2, C4_2, C7_1, C8_1 | CAP0265 |  | YES | Digi-Key | 478-1249-1-ND | D5_AVX | 0603YD105KAT2A | CAP CER 1uF 16V 10% X5R SMD 0603 |  |  |  |  |  |  |  |  |  | Yes | Fitted
C5_1 | CAP2488 |  | YES | Digi-Key | 732-7793-1-ND | Würth Elektronik | 885012006051 | CAP CER 10pF 5% 50V C0G SMD 0603 |  |  |  |  |  |  |  |  |  | YES | Fitted
C5_2 | CAP0088 |  | YES | Cal-Chip | GMC10CG330J50NTLF | Cal-Chip | GMC10CG330J50NTLF | CAP CER 33pF 50V 5% NP0 SMD 0603 |  |  |  |  |  |  |  |  |  | Yes | Fitted
C6_1 | CAP2468 |  | YES | Digi-Key | 311-3919-1-ND | Yageo | CC0603GRNPO9BN130 | Ceramic capacitor, SMD 0603, 13pF, NP0, 50V, +/-2% |  |  |  |  |  |  |  |  |  | YES | Fitted
C6_2 | CAP1048 |  | YES | Digi-Key | 445-1269-1-ND | TDK Corporation | C1608C0G1H100D | CAP CER 10pF 50V 0.5pF C0G SMD 0603 |  |  |  |  |  |  |  |  |  | YES | Fitted
C7_2, C11_1, C13_1 | CAP0384 |  | YES | Digi-Key | 490-3302-1-ND | Murata | GRM188F51A475ZE20D | CAP CER 4.7uF 10V 80% Y5V SMD 0603 |  |  |  |  |  |  |  |  |  | Yes | Fitted
C8_2, C9_2 | CAP1229 |  | YES | Digi-Key | 490-10717-1-ND | Murata | GRM1885C1H3R3CA01D | CAP CER 3.3pF 50V 0.25pF NP0 SMD 0603 |  |  |  |  |  |  |  |  |  | YES | Fitted
C9_1 | CAP0533 |  | YES | Digi-Key | 478-5318-2-ND | AVX | 06036D106MAT2A | CAP CER 10uF 6.3V 20% X5R SMD 0603 |  |  |  |  |  |  |  |  |  | Yes | Fitted
C15_1 | CAP0036 |  | YES | Digi-Key | 709-1176-1-ND | D3_Johanson Dielectrics Inc | 500R15N101JV4T | CAP CER 100pF 50V 5% C0G SMD 0805 |  |  |  |  |  |  |  |  |  | DNP | Not Fitted
D1_1, D2_2, D3_2, D4_1 | LED0063 |  | YES | Digi-Key | 160-1436-1-ND | Lite-On | LTST-C190KRKT | DIO LED RED 1.8V 40mA 10mcd Clear SMD 0603 |  |  |  |  |  |  |  |  |  | YES | Fitted
D2_1 | DIODE1056 |  | YES | Digi-Key | 160-1827-1-ND | Lite-On | LTST-C193TBKT-5A | DIO LED BLUE 2.8V 20mA 15mcd Clear SMD 0603 |  |  |  |  |  |  |  |  |  | YES | Fitted
D3_1 | DIODE1242 |  | YES | Mouser | 720-LTQ39GQ1S22515 | Mouser | 720-LTQ39GQ1S22515 | Standard LEDs - SMD True Green |  |  |  |  |  |  |  |  |  | YES | Fitted
J2_1 | CON0066 |  | YES | Digi-Key | SAM1209-04-ND | Samtec | SSW-104-01-G-S | CON HDR-2.54 Female 1x4 Gold TH VERT |  |  |  |  |  |  |  |  |  | YES | Fitted
J3_1, J4_1 | CON1113 |  | YES | Digi-Key | S7006-ND | Sullins | PPTC081LFBN-RC | CON HDR-2.54 Female 1x8 Tin TH VERT |  |  |  |  |  |  |  |  |  | Yes | Fitted
L1_2, L2_2 | IND0008 |  | YES | Digi-Key | LL1608-FSL15NJ-ND | TOKO America | LL1608-FSL15NJ | INDUCTOR 15nH 600mA 5% SMD 0603 |  |  |  |  |  |  |  |  |  | Yes | Fitted
L3_2 | IND1285 |  | YES | Digi-Key | 490-12065-2-ND | Murata | LQM18PN4R7MFRL | INDUCTOR 4.7uH 620mA 20% SMD 0603 |  |  |  |  |  |  |  |  |  | YES | Fitted
Q1_2, Q2_2, Q3_2 | TRA1102 |  | YES | Digi-Key | 2N7002-FDICT-ND | Diodes Inc | 2N7002-7-F | TRANS FET N-CH 2N7002-7-F 60V 170mA 370mW SOT-23-3 |  |  |  |  |  |  |  |  |  | YES | Fitted
R1_1 | RES1144 |  | YES | Digi-Key | P220KHCT-ND | Panasonic | ERJ-3EKF2203V | RES TKF 220k 1% 1/10W SMD 0603 |  |  |  |  |  |  |  |  |  | Yes | Fitted
R1_2, R2_2, R3_2 | RES1560 |  | YES | Digi-Key | P22.0HCT-ND | Panasonic Electronic Components | ERJ-3EKF22R0V | RES TKF 22R 1% 1/10W SMD 0603 |  |  |  |  |  |  |  |  |  | YES | Fitted
R2_1 | RES1184 |  | YES | Digi-Key | P470KGCT-ND | Panasonic | ERJ-3GEYJ474V | RES TKF 470k 5% 1/10W SMD 0603 |  |  |  |  |  |  |  |  |  | Yes | Fitted
R3_1, R8_1, R9_1, R11_1, R12_1, R13_1, R15_2, R16_2 | RES0194 |  | YES | Digi-Key | RHM220GCT-ND | ROHM | MCR03EZPJ221 | RES TKF 220R 5% 1/10W SMD 0603 |  |  |  |  |  |  |  |  |  | Yes | Fitted
R4_1, R6_2, R7_2, R8_2 | RES2360 |  | YES | Digi-Key | P0.0GCT-ND | Panasonic Electronic Components | ERJ-3GEY0R00V | RES TKF 0R 1/10W SMD 0603 AEC-Q200 |  |  |  |  |  |  |  |  |  | YES | Fitted
R4_2, R5_1, R7_1, R11_2, R12_2 | RES1178 |  | YES | Digi-Key | P4.7KGCT-ND | Panasonic | ERJ-3GEYJ472V | RES TKF 4.7k 5% 1/10W SMD 0603 |  |  |  |  |  |  |  |  |  | Yes | Fitted
R5_2, R13_2, R14_2 | RES1183 |  | YES | Digi-Key | P47.0KHCT-ND | Panasonic | ERJ-3EKF4702V | RES TKF 47k 1% 1/10W SMD 0603 |  |  |  |  |  |  |  |  |  | YES | Fitted
R6_1 | RES1178 |  | YES | Digi-Key | P4.7KGCT-ND | Panasonic | ERJ-3GEYJ472V | RES TKF 4.7k 5% 1/10W SMD 0603 |  |  |  |  |  |  |  |  |  | DNP | Not Fitted
R9_2, R10_2 | RSMT0752 |  | YES | Digi-Key | 311-5.60KHRCT-ND | Yageo | RC0603FR-075K6L | RES TKF 5.6k 1% 1/10W SMD 0603 |  |  |  |  |  |  |  |  |  | DNP | Not Fitted
R10_1 | RES1015 |  | YES | Digi-Key | P1.0KDBTR-ND | Panasonic - ECG | ERA-3AEB102V | RES TF 1k 0.1% 1/10W SMD 0603 |  |  |  |  |  |  |  |  |  | YES | Fitted
R14_1 | RES2774 |  | YES | Digi-Key | P22.1KDBCT-ND | Panasonic Electronic Components | ERA-3AEB2212V | RES TF 22.1k 0.1% 1/10W SMD 0603 AEC-Q200 |  |  |  |  |  |  |  |  |  | YES | Fitted
R15_1 | RES1543 |  | YES | Digi-Key | 541-47.5KHCT-ND | Vishay | CRCW060347K5FKEA | RES TKF 47.5k 1% 1/10W SMD 0603 |  |  |  |  |  |  |  |  |  | YES | Fitted
R16_1 | RES2360 |  | YES | Digi-Key | P0.0GCT-ND | Panasonic Electronic Components | ERJ-3GEY0R00V | RES TKF 0R 1/10W SMD 0603 AEC-Q200 |  |  |  |  |  |  |  |  |  | DNP | Not Fitted
R17_1 | RSMT0786 |  | YES | Digi-Key | CRT0805-BY-1004ELFCT-ND | Bourns | CRT0805-BY-1004ELF | RES TF 1M 0.1% 1/8W SMD 0805 |  |  |  |  |  |  |  |  |  | DNP | Not Fitted
TP1, TP2, TP3, TP4, TP5 | CON0182 |  | YES | Digi-Key | SAM1029-01-ND | Samtec Inc. | TSW-101-07-G-S | CON HDR-2.54 Male 1x1 Gold 5.84MH TH VERT |  |  |  |  |  |  |  |  |  | YES | Fitted
U3_1 | MIC2541 |  | YES | Microchip | MCP1702T-2802E/MB | Microchip | MCP1702T-2802E/MB | MCHP ANALOG LDO 2.8V MCP1702T-2802E/MB SOT-89-3 |  |  |  |  |  |  |  |  |  | Yes | Fitted
Y1_1 | OSC1250 |  | YES | Microchip Technology | VMK3-9001-32K7680000 | Microchip Technology | VMK3-9001-32K7680000 | MCHP CRYSTAL 32.768kHz 9pF VMK3-9001-32K7680000 SMD L3.2W1.5XH0.9 |  |  |  |  |  |  |  |  |  | YES | Fitted

Sheet: Product Compliance Description
RoHS 3 Yes/No | RoHS Exemption (Value) | REACH Conformant (Yes/No) | Halogen Free (Yes/No) | FMD Available (Yes/No) | Weight (mg) | China RoHS (Affected/Unaffected)
Yes - Manufacturer Part Numbers (MPN) is compliant to RoHS 3. Additionally, the documentation found is in conformance with the requirements specified in EN50581:2012. The following 3 categories are sufficient to meet these requirements 1. Supplier declarations 2. Material declarations 3. Analytical test results A "Yes: declaration further states whether any homogeneous material; as defined by Directive 2015/863/EU on the Restriction of Use of Certain Hazardous Substances in Electrical and Electronic Equipment (RoHS 3); of the parts identified on this Declaration, contain no substances listed above the identified limits. Except for specific application exemptions listed in this document (RoHS Exemption Column), and PMC / the BU was able to find supporting documentation to prove this. No - MPN is not compliant to RoHS and a CE mark can not be placed on the finished product until the non-compliant MPN is replaced. A "No" declaration further states whether any homogeneous material; as defined by Directive 2015/863/EU on the Restriction of Use of Certain Hazardous Substances in Electrical and Electronic Equipment (RoHS); of the parts identified on this Declaration, contain substances listed above the identified limits. Manufacturer Part Numbers (MPN) and products supplied to Microchip or its subsidiaries shall not contain RoHS restricted substances greater than 0.1% (1000 PPM) for Lead (Pb), Mercury (Hg), Hexavalent Chromium (Cr 6+) in pigments or plastics, Polybrominated Biphen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 | This section of the Declaration states whether any Manufacturer Part Numbers (MPN) identified in this form is compliant to RoHS with an RoHS exemption. All exemptions need to be rolled into the final Declaration of Conformity. *Please use this column as a warning that this MPN could contain RoHS Restricted Substances in excess of the limits put forth in RoHS 2 Amendment Directive 2015/863/EU / "RoHS 3". RoHS exemptions have expiration dates as such use of MPNs that are compliant with exemptions carry risk of that your product will become non-compliant to RoHS in the future. | Yes - Manufacturer Part Numbers (MPN) is compliant to the latest revision of REACH. Additionally the documentation found is in conformance with the requirements specified in EN50581:2012. The following 3 categories are sufficient to meet these requirements. 1. Supplier declarations 2. Material declarations 3. Analytical test results Yes - CAS #XXX - Manufacturer Part Numbers (MPN) is compliant to the latest revision of REACH. Additionally, the documentation found is in conformance with the requirements specified in EN50581:2012. The following 3 categories are sufficient to meet these requirements. 1. Supplier declarations 2. Material declarations 3. Analytical test results However, a REACH Customer Declaration is required contact Legal for more information. No - REACH XXX- Unable to make REACH Determination with information available. No - REACH XXX- CAS #XXX Unable to make the latest REACH Determination with information available. However, previous information states SVHC's are present above w/w thresholds. No - MPN is not conformant to REACH. Authorization List SVHC listed. finished product can not be placed in the EU until the non-compliant MPN is replaced. Unknown - No Information Available to Make a REACH Determination. Unknown - CAS #XXX - No Information Available to Make a REACH Determination, however, RoHS information available lists CAS number above concentration thresholds. If you have additional questions about your REACH obligations please refer to SPI-50418 and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 | Halogen Free - Under - IEC 61249-2-21 the term “Halogen-Free”, does not necessarily indicate a complete absence of Halogens. -Chlorine and Bromine -Fluorine proposed as possibly in scope for halogen-free electronics standard, not currently in scope for PCB laminates -Astatine and Iodine -Current standards (for PCB laminate materials) define halogen-free as: • < 900ppm of Br • < 900ppm of Cl • <1500ppm of both combined (concentration limits are applied at the homogeneous level) Yes - Manufacturer Part Numbers (MPN) is Halogen Free as defined in IEC 61249-2-21 No - Manufacturer Part Numbers (MPN) is not Halogen Free as defined in IEC 61249-2-21 Unknown - No Information Available to determine if this Manufacturer Part Numbers (MPN) is Halogen Free | Yes - Full Material Declaration available for this Manufacturer Part Numbers (MPN) No - Full Material Declaration not available for this MPN Unknown - No Information Available to determine if an FMD is available | If FMD Available equals "Yes" then Manufacturer Part Numbers (MPN) weight inserted here. | Unaffected - Manufacturer Part Numbers (MPN) is compliant to China RoHS and no Table Declaration is required for this part. Affected - Manufacturer Part Numbers (MPN) is compliant to China RoHS, however, additional declaration information is required. Required - Orange symbol with a number in it: This product contains certain hazardous substances and can be used safely during its environmental friendly use period (EFUP) (as indicated by the number in the center) which should enter into the recycling system after its environmental protection use period. EFUP for all enclosed products and their parts are per the symbol shown here, unless otherwise marked. The EFUP is valid only when the product is operated under the conditions defined in the product manual. Required - Creation of a Hazardous Substances table. Table should be provided where product contains above identified substances in excess of the indicated concentration limits and shipped with the product. An example of a China RoHS Certificate that meets this requirement is in Annex E-1 of SPI-50418 If you have additional questions about your China RoHS obligations please refer to SPI-50418 for more information. Unknown - No Information Available to determine if this Manufacturer Part Numbers (MPN) is Affected by China RoHS
