adrianntz/gpstracker/Hardware/List of Components.txt

https://ro.mouser.com/ProjectManager/ProjectDetail.aspx?AccessID=359f53874c
