adrianntz/gpstracker/Documentation/SIM808 GSM/SIM808_AT_Communication_Bring_up.pdf

## GSM/GPS Bring-up Communication

Communication with the GSM/GPS module SIM808 is available through basic 2 wire serial communication, mostly known as Universal asynchronous receiver-transmitter (UART), using AT commands. The module will always respond with either OK and the necessary information or ERROR if there is a problem with the command.

The syntax of an AT command is “AT+<command>”, and there are three types of AT commands:

1. Test Command ( AT+<command>=?) in which the SIM808 module responds with the list of available options that can be set within that command.
Example for the CEER command:

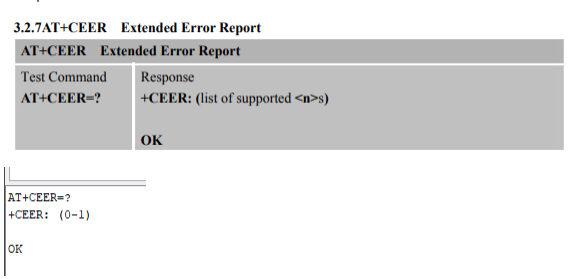
[picture p5: figure]

The response lists the available settings for that command (in this case 0 or 1)

2. Read command (AT+<command>?), which has the role to respond with the current state of the command.

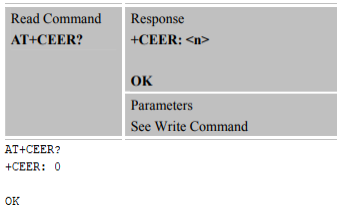
[picture p6: figure]

In this case, the current state is 0.

3. Execution command(AT+<command>=x) where x is the setting that the user wants to set. For the CEER command we cand execute AT+CEER=1 which will set it to 1 instead of 0.

The communication will be automated through the AVR128DA48 microcontroller in which we will perform the following procedures:

- GPS Coordinates interrogation
- SMS GPS Data Transfer
- Module Sleep Mode
- Module wake up

## Module Sleep Mode

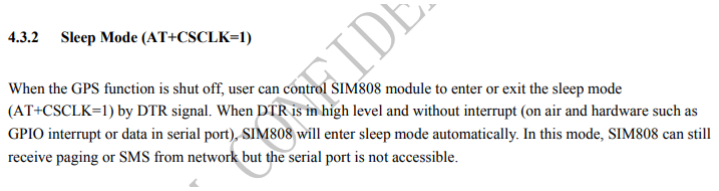
[picture p7: figure]

In order for the module to enter sleep mode, we have to turn off the GPS function first.

This is performer with the AT+CGPSPWR command.

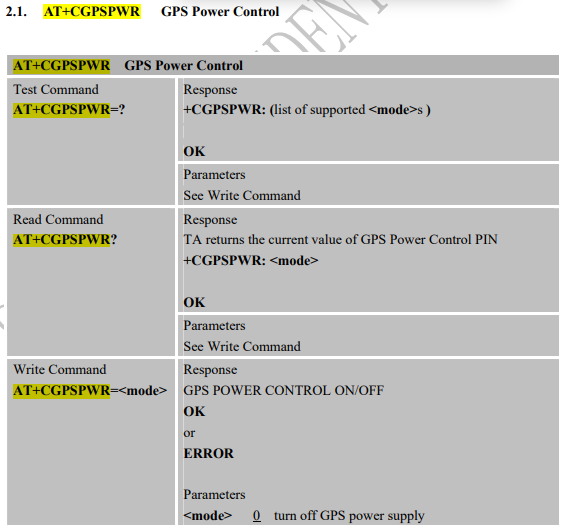
[picture p8: figure]
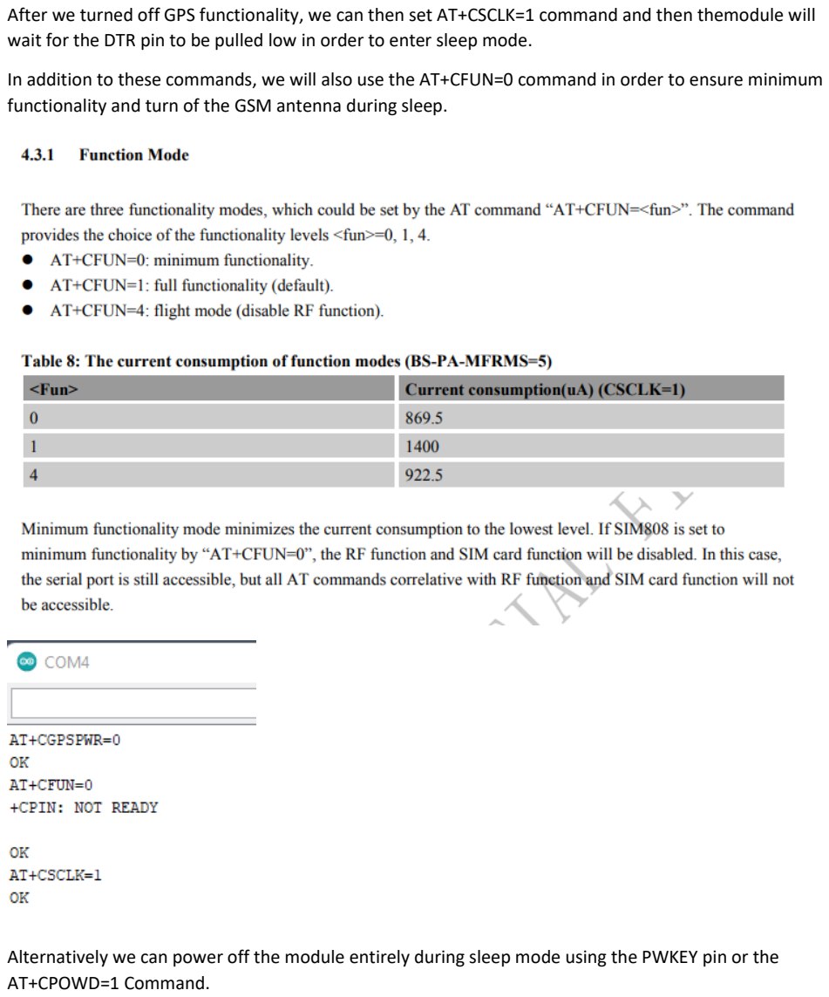
[picture p9: page 3]

After we turned off GPS functionality, we can then set AT+CSCLK=1 command and then themodule will wait for the DTR pin to be pulled low in order to enter sleep mode.

In addition to these commands, we will also use the AT+CFUN=0 command in order to ensure minimum functionality and turn of the GSM antenna during sleep.

Alternatively we can power off the module entirely during sleep mode using the PWKEY pin or the AT+CPOWD=1 Command.

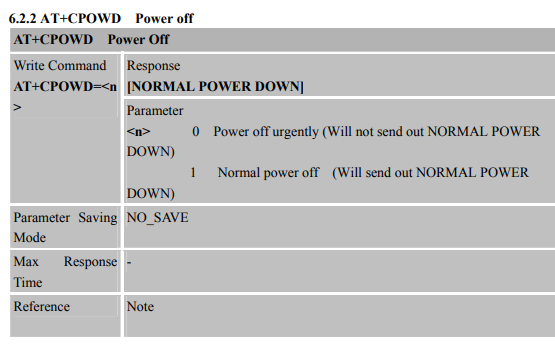
[picture p10: figure]

## Module Wake up

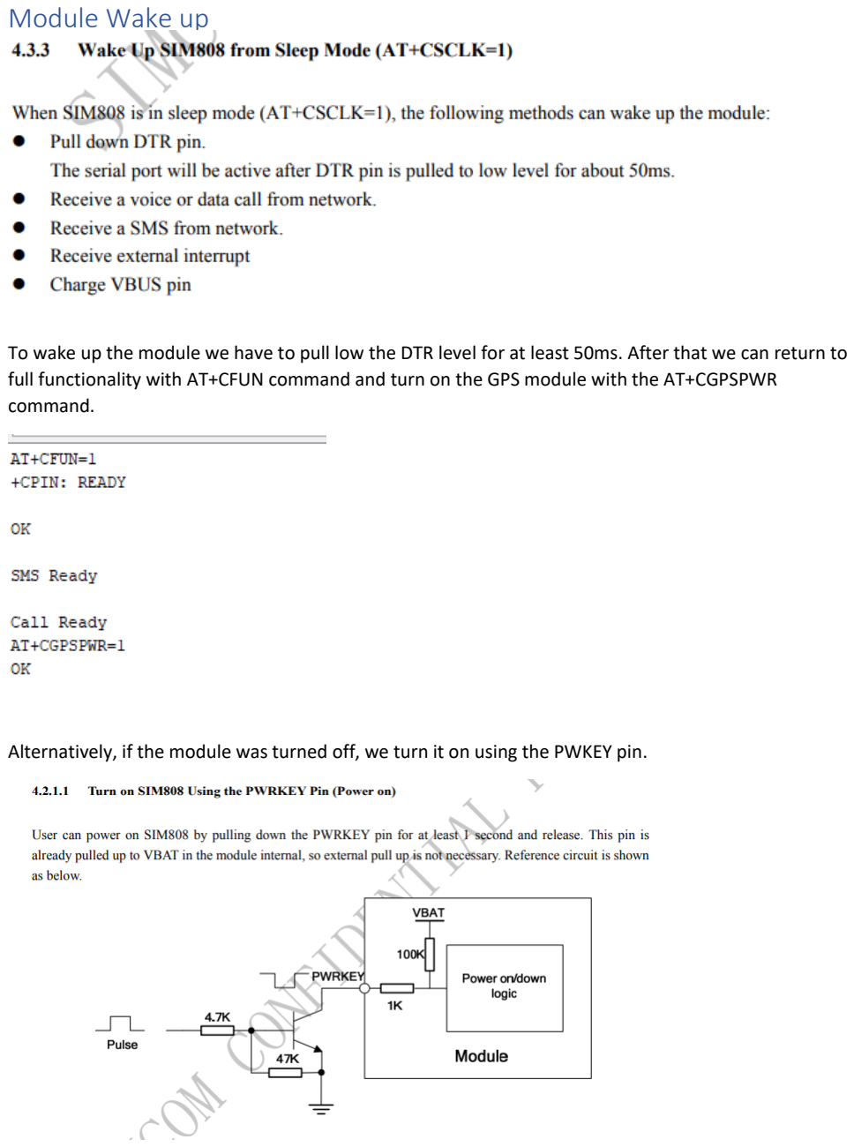
[picture p11: page 5]

To wake up the module we have to pull low the DTR level for at least 50ms. After that we can return to full functionality with AT+CFUN command and turn on the GPS module with the AT+CGPSPWR command.

Alternatively, if the module was turned off, we turn it on using the PWKEY pin.

## GPS Coordinates Interrogation

To receive the GPS coordinates we have to make sure the GPS is turned on. After that, we use the AT+CGPSOUT command to receive the GPS data in GPGGA format.

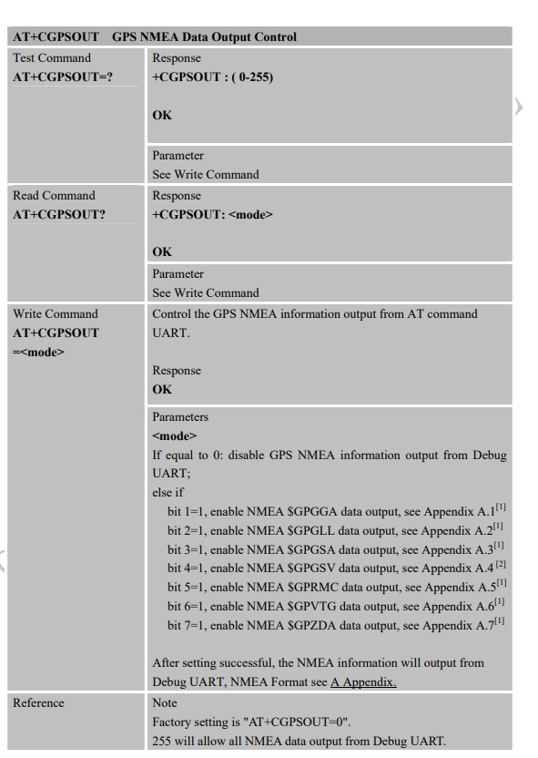
[picture p12: figure]

If this setting is non-zero, the module will send data once every second through the UART channel. To stop the data transmission, we set this setting to 0. Using this command we can fill a buffer with the GPGGA data and parse it afterwards.

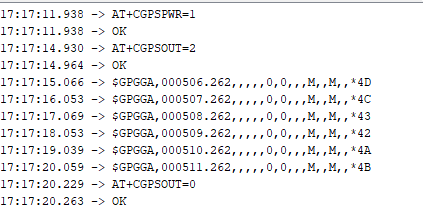
[picture p13: figure]

## SMS GPS Data Transfer

In order to send data we first have to make sure the SIM card is being read by the module. For that we can use the AT+CPIN? command

After that we have to set the SMS mode to text mode.

Afterward we use the AT+CMGS command to send the actual text message. First, we send AT+CMGS=”<phone number>” in order to store the phone number that will receive the message.

After that we send the actual text message. To end the text message we have to finish our text with the CTRL+Z character (26 in ASCII).

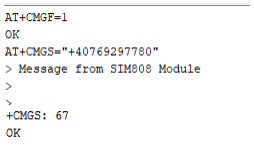
[picture p14: figure]

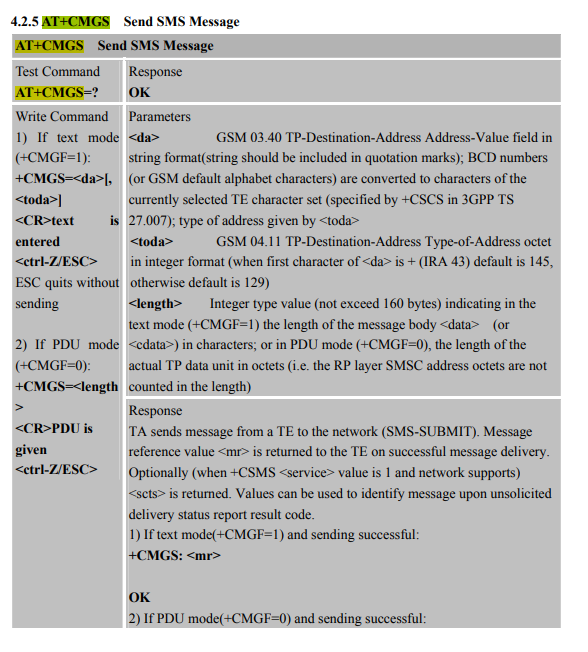
[picture p15: figure]
