adrianntz/gpstracker/Documentation/6DOF IMU 2 CLICK/6-dof_imu-2-click-schematic.pdf

# 6DOF IMU 2 click schematic v100

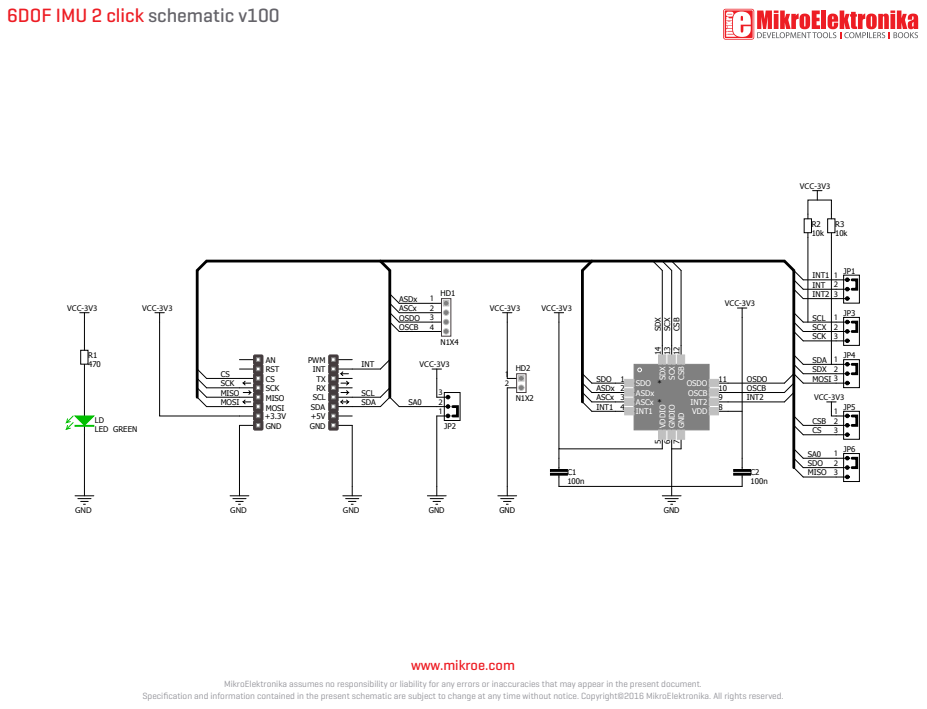
[picture p16: page 1]

MikroElektronika assumes no responsibility or liability for any errors or inaccuracies that may appear in the present document.

Specification and information contained in the present schematic are subject to change at any time without notice. Copyright©2016 MikroElektronika. All rights reserved.
