adrianntz/gpstracker/Hardware/Design/Project_Outputs/DevTools/03-ProjectPCBAssyNumber-RProjectRevisionSCH.PDF

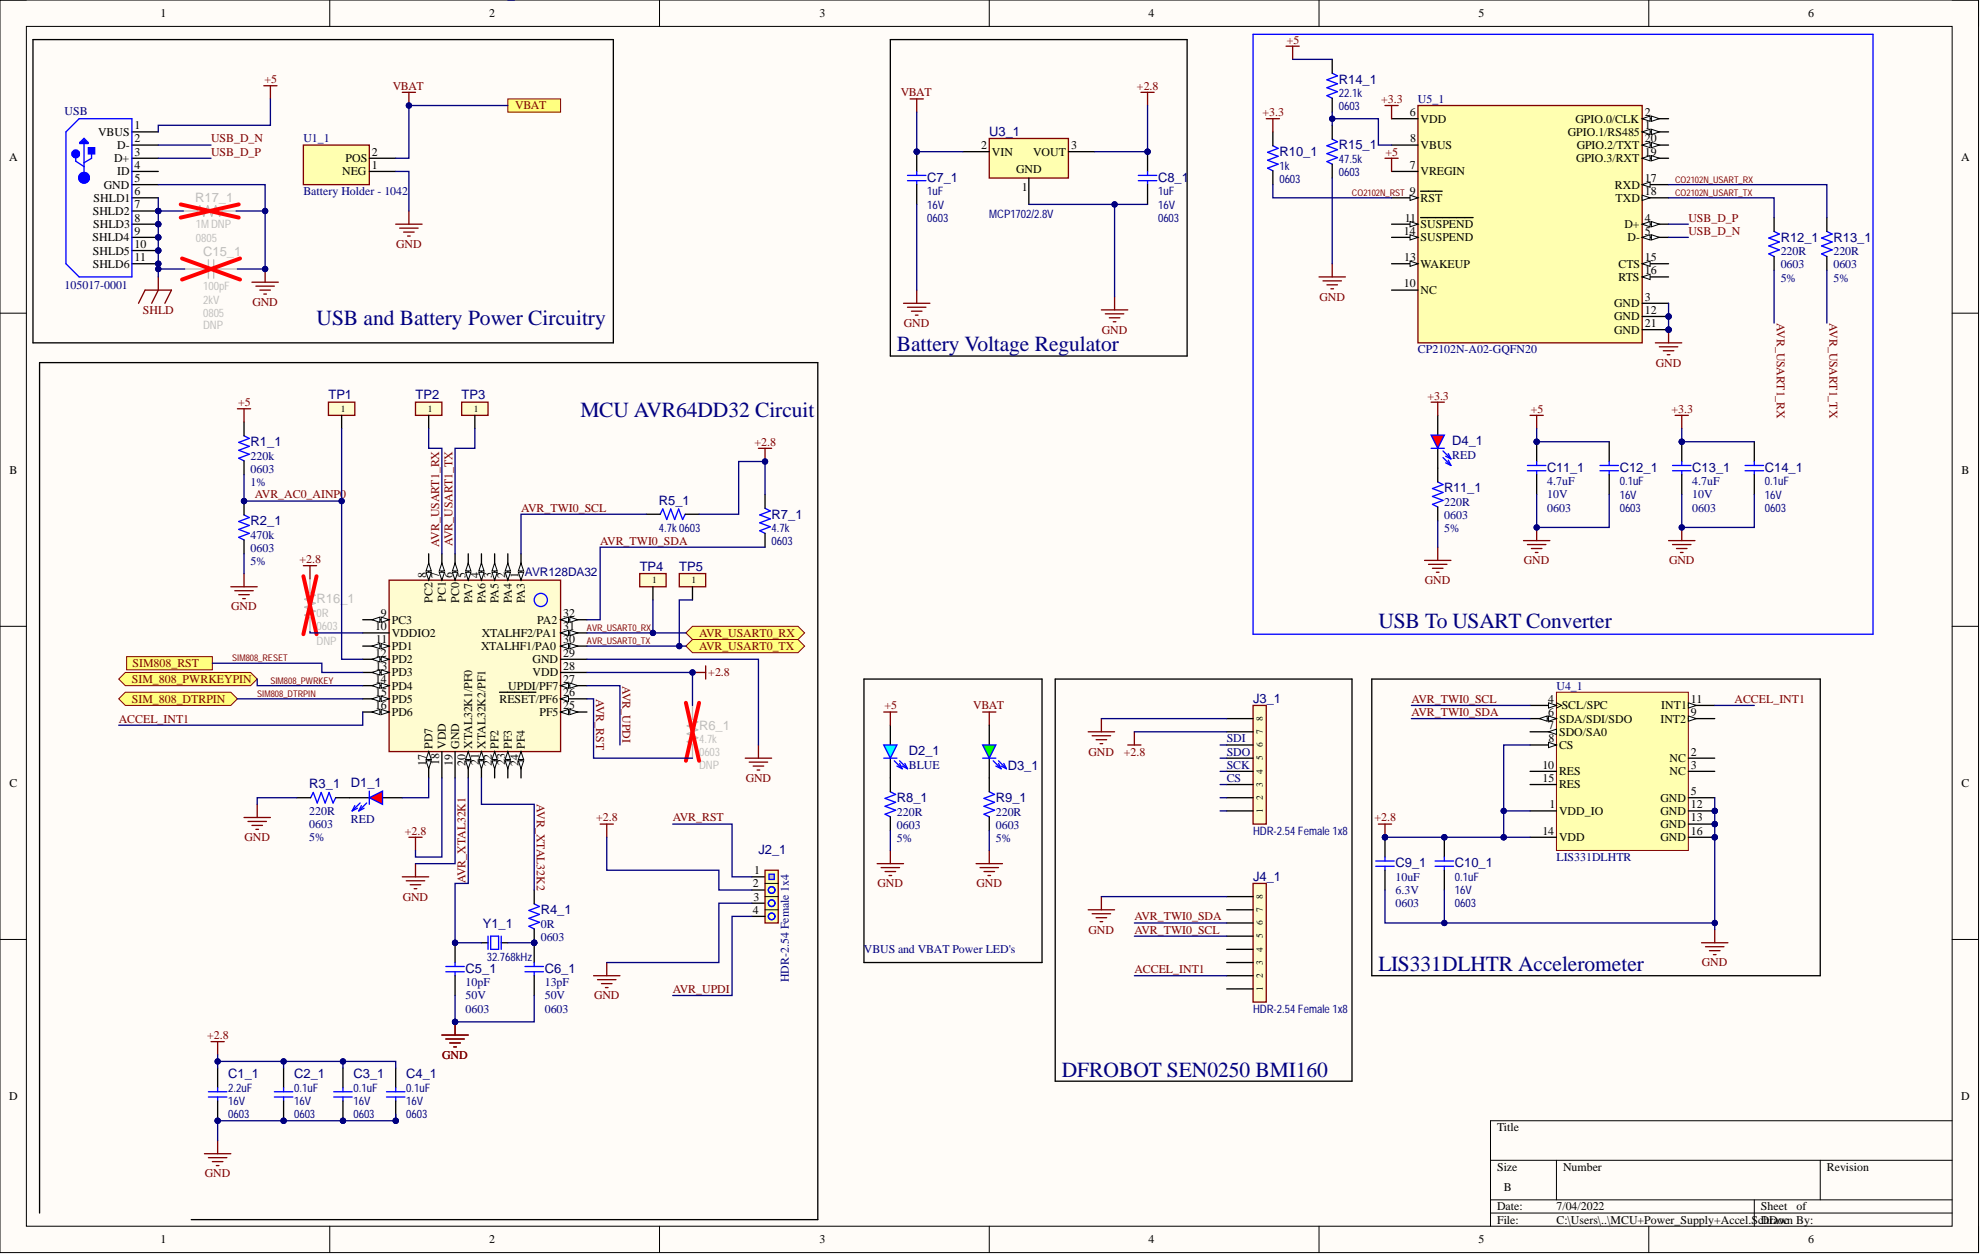
[picture p17: page 1]

USB and Battery Power Circuitry

USB To USART Converter

VBUS and VBAT Power LED's

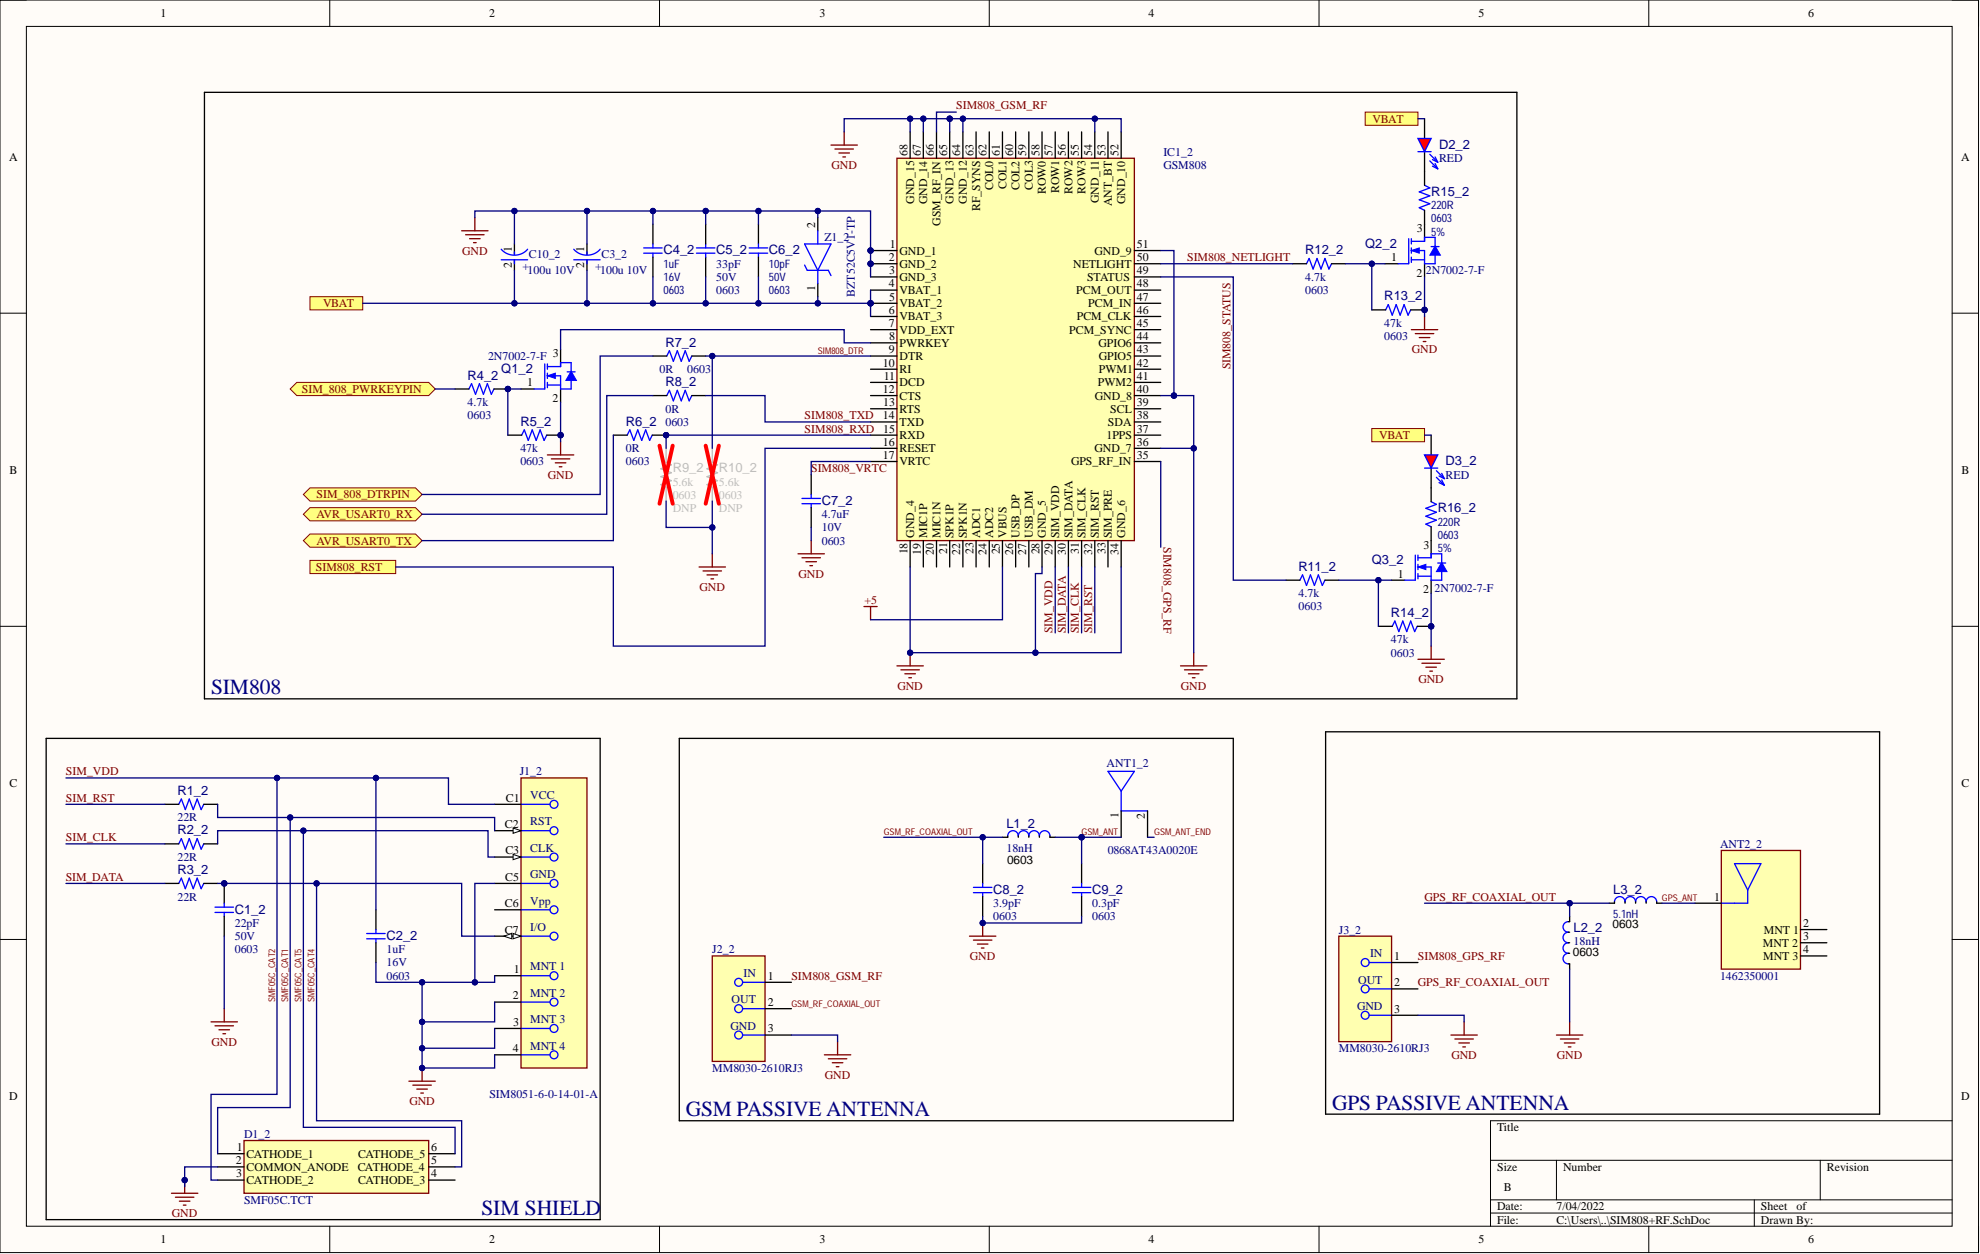
[picture p18: page 2]

CATHODE_1 1

CATHODE_2 3
