adrianntz/gpstracker/Hardware/Design/Project_Outputs/PCB_Drawings/04-ProjectPCBNumber-RProjectRevisionART-D-PCB.PDF

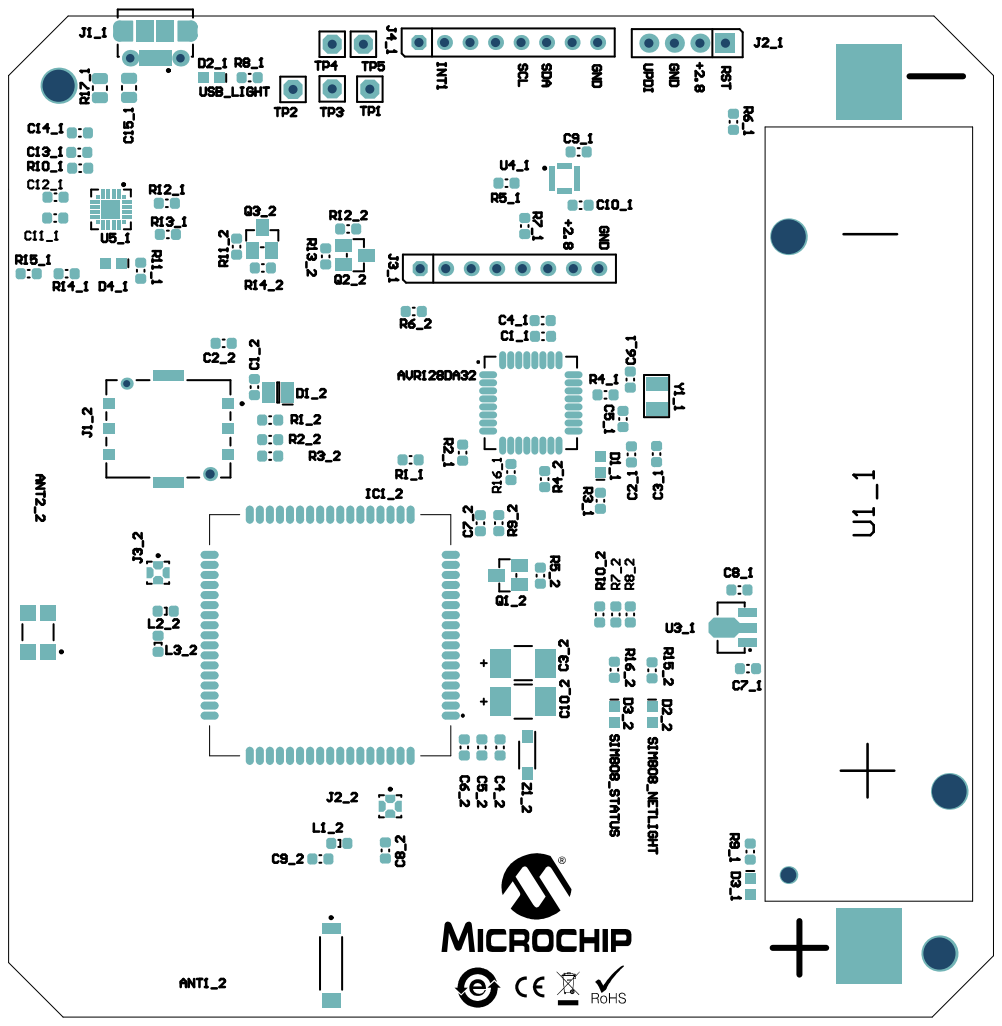
[picture p19: page 1]

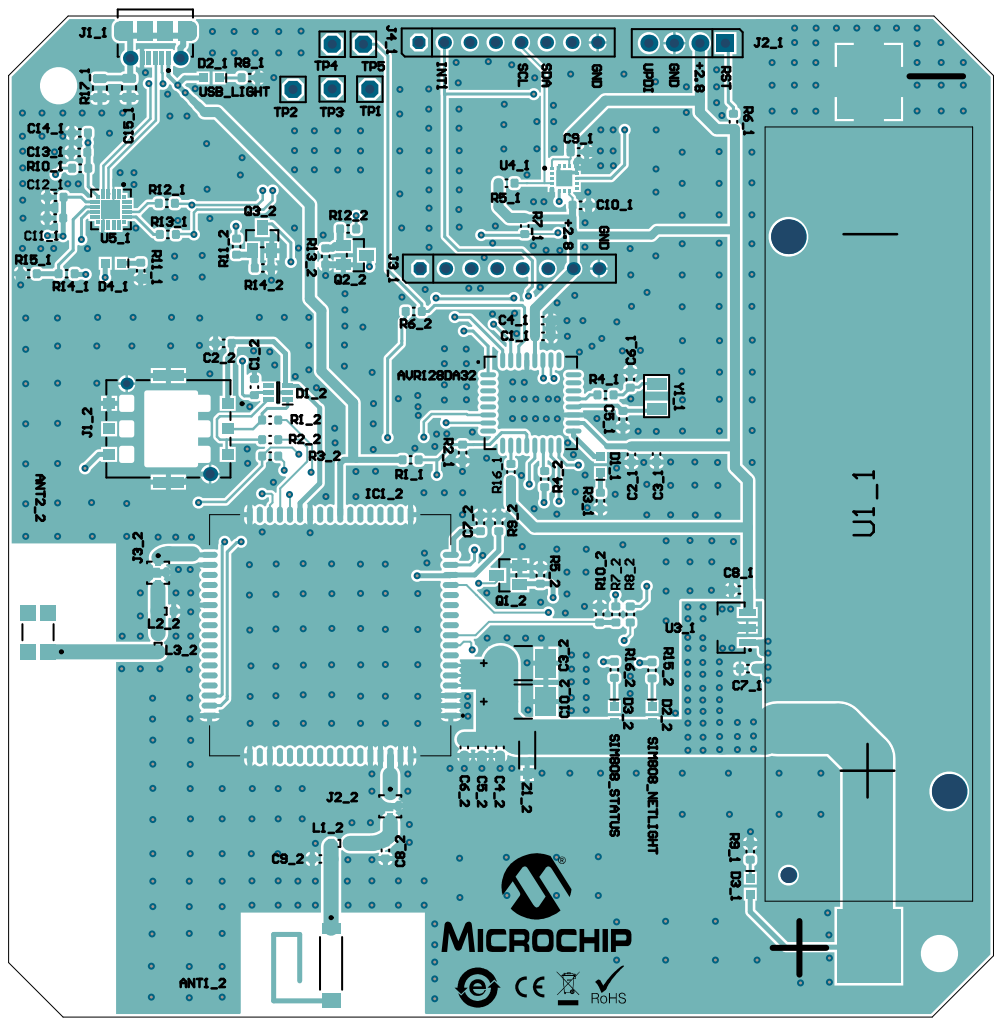
[picture p20: page 2]

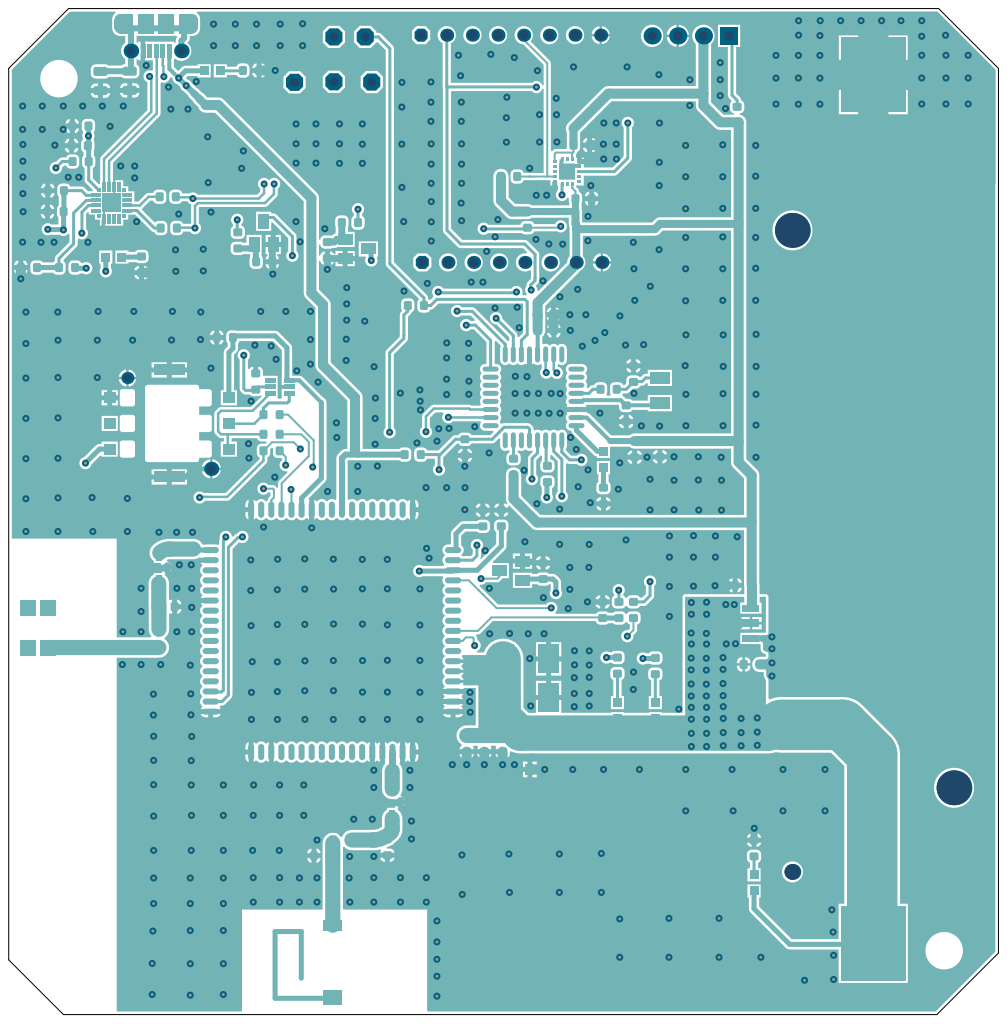
[picture p21: page 3]

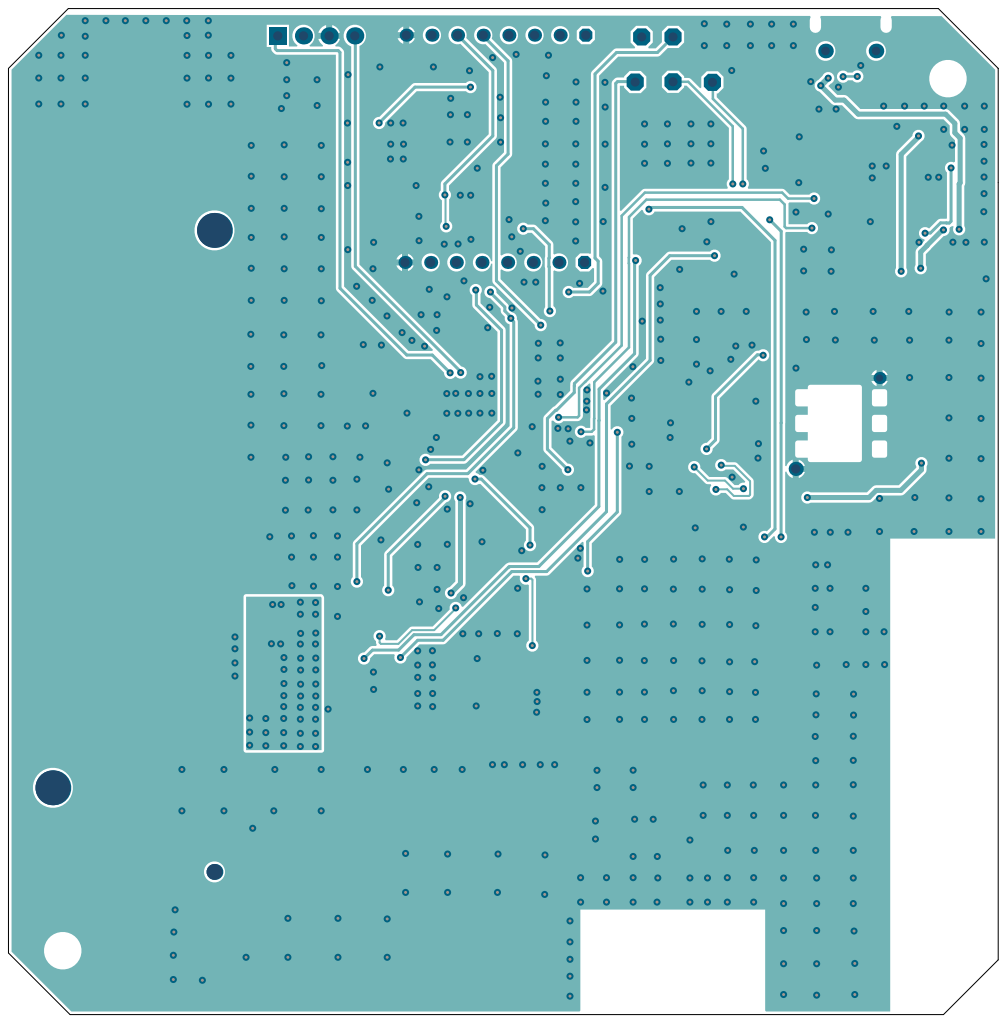
[picture p22: page 4]

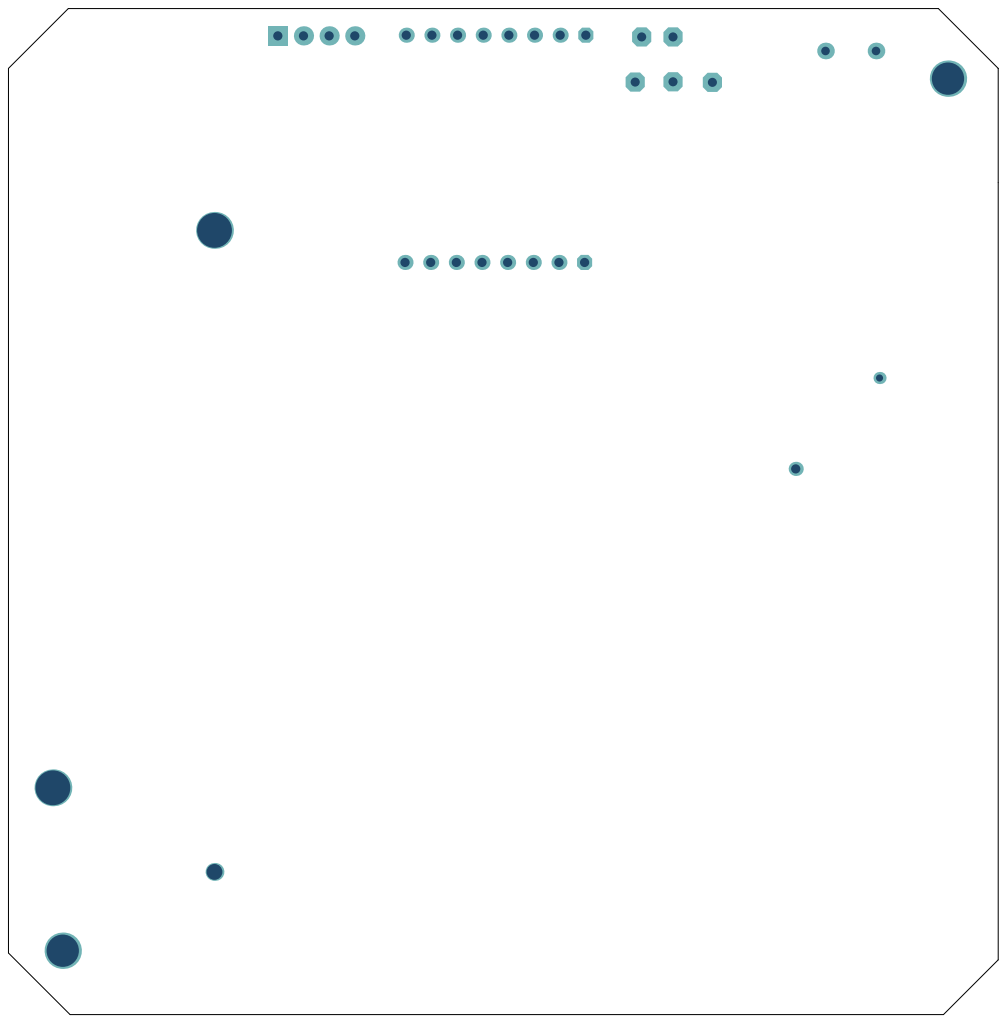
[picture p23: page 6]

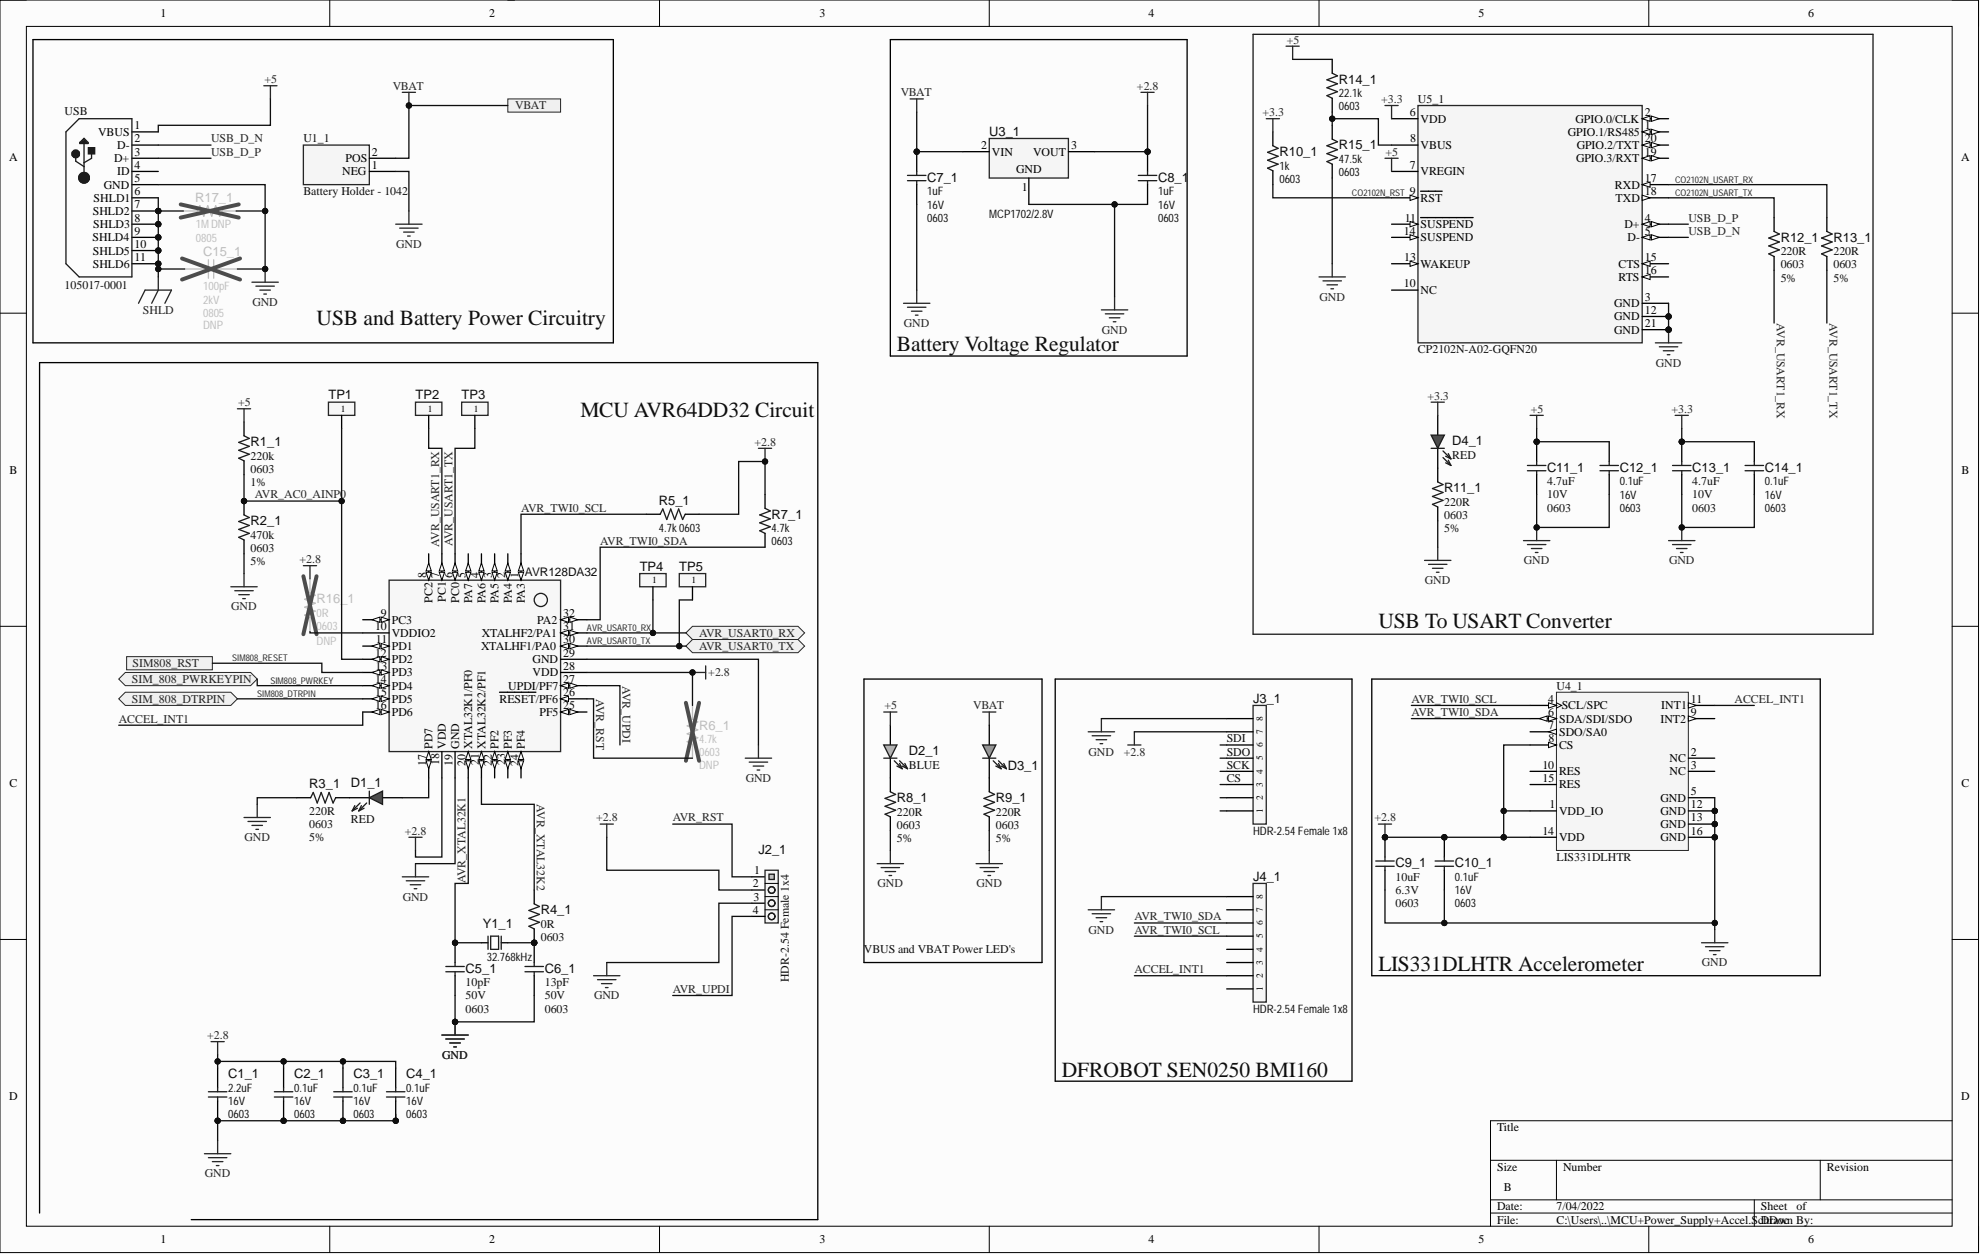
[picture p24: page 7]

USB and Battery Power Circuitry

USB To USART Converter

VBUS and VBAT Power LED's

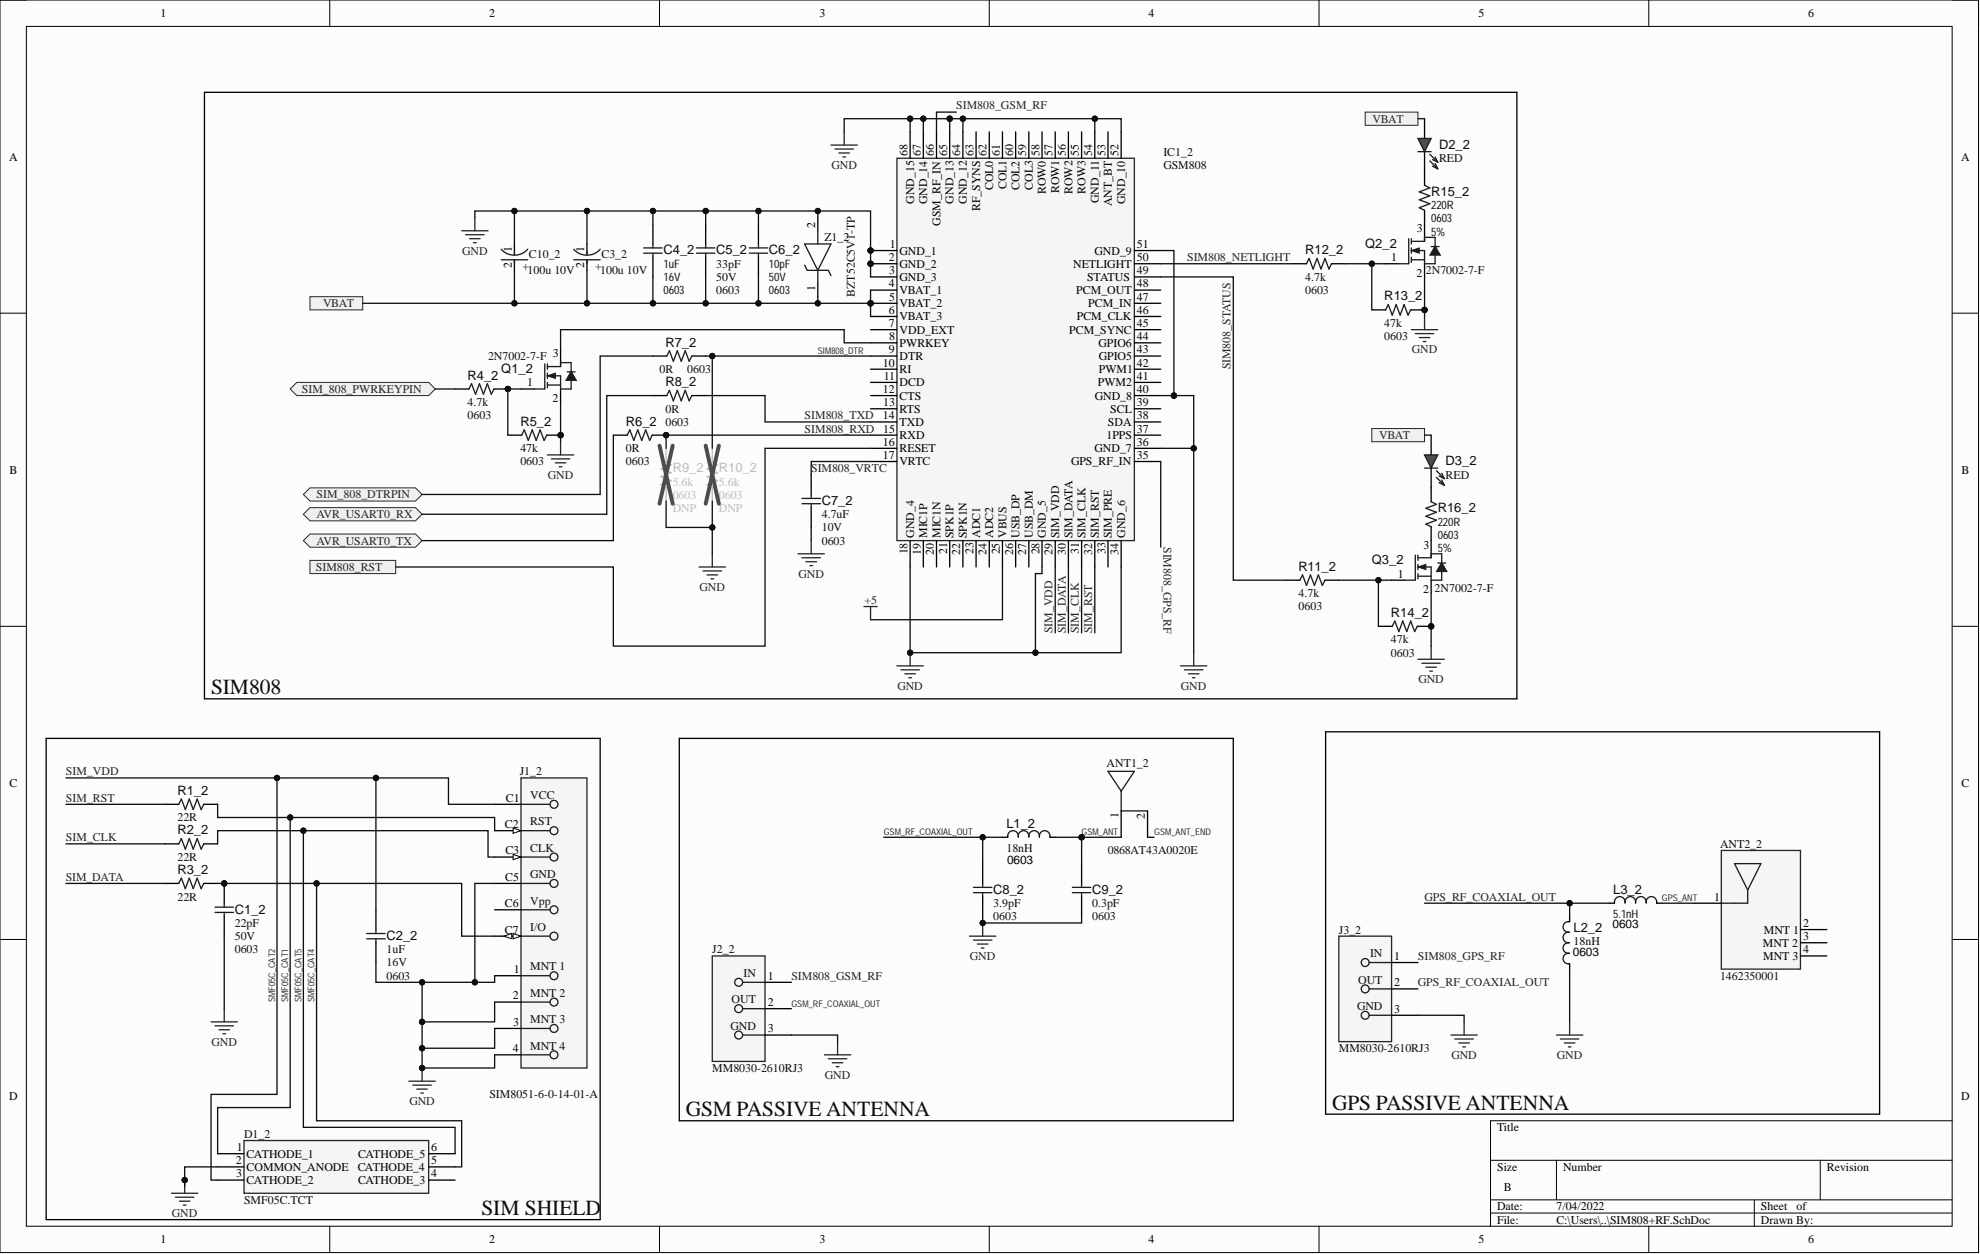
[picture p25: page 8]

CATHODE_1 1

CATHODE_2 3

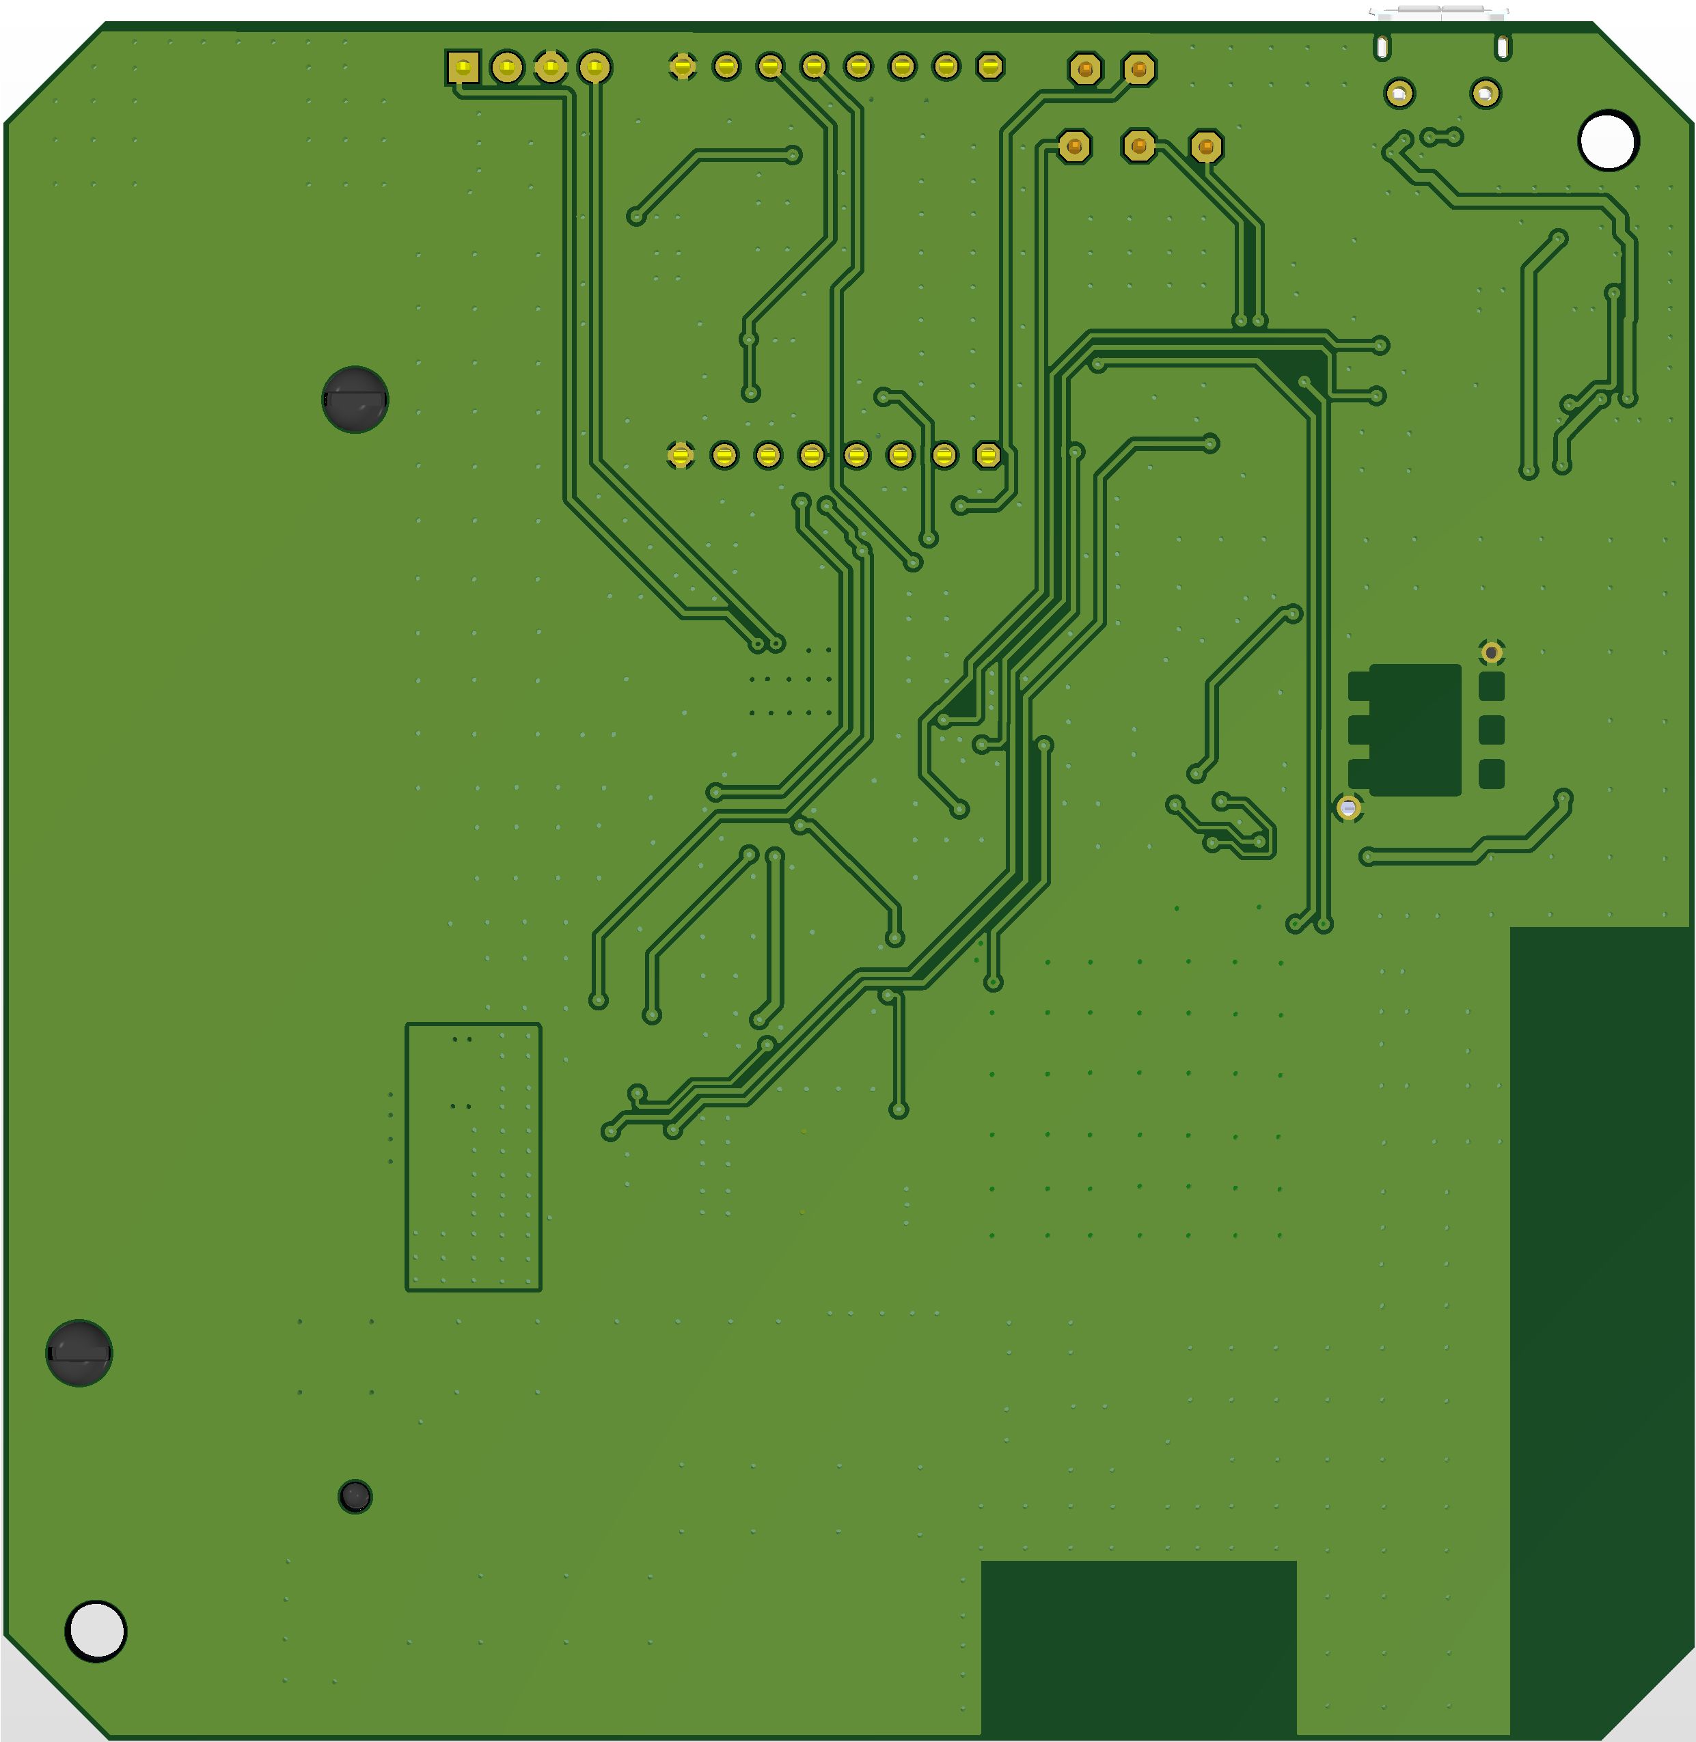
[picture p26: page 9]

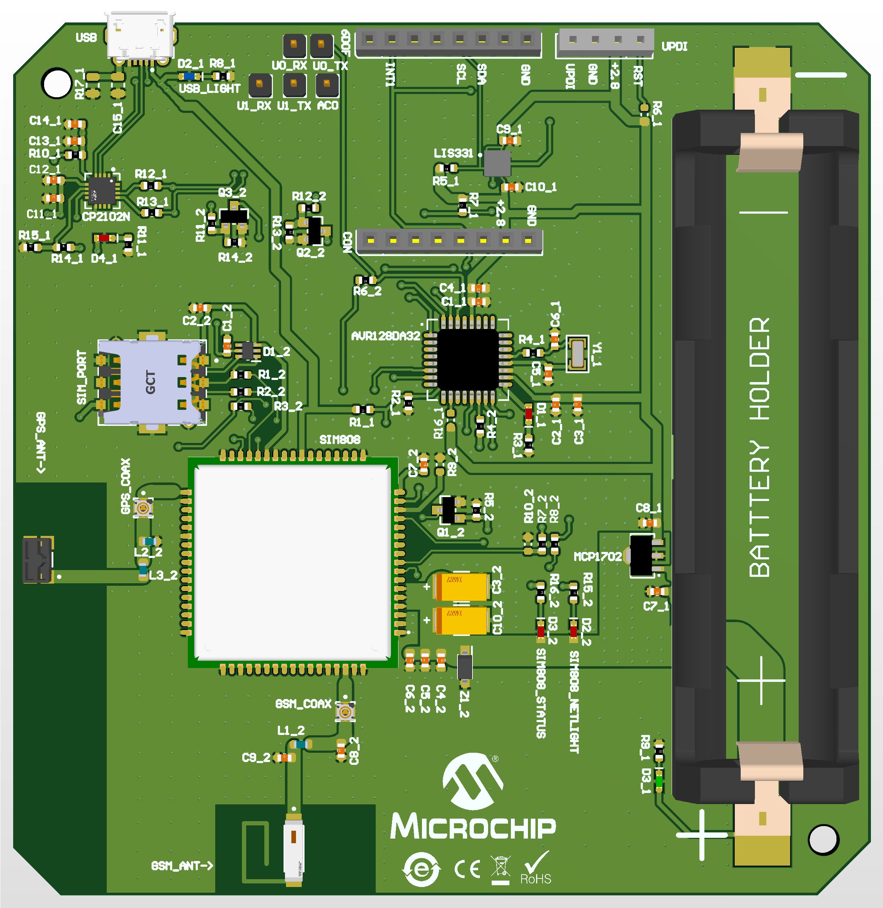
[picture p27: page 10]
