adrianntz/gpstracker/Hardware/Design/Project_Outputs/DevTools/02-ProjectPCBAssyNumber-RProjectRevisionASSY-D.PDF

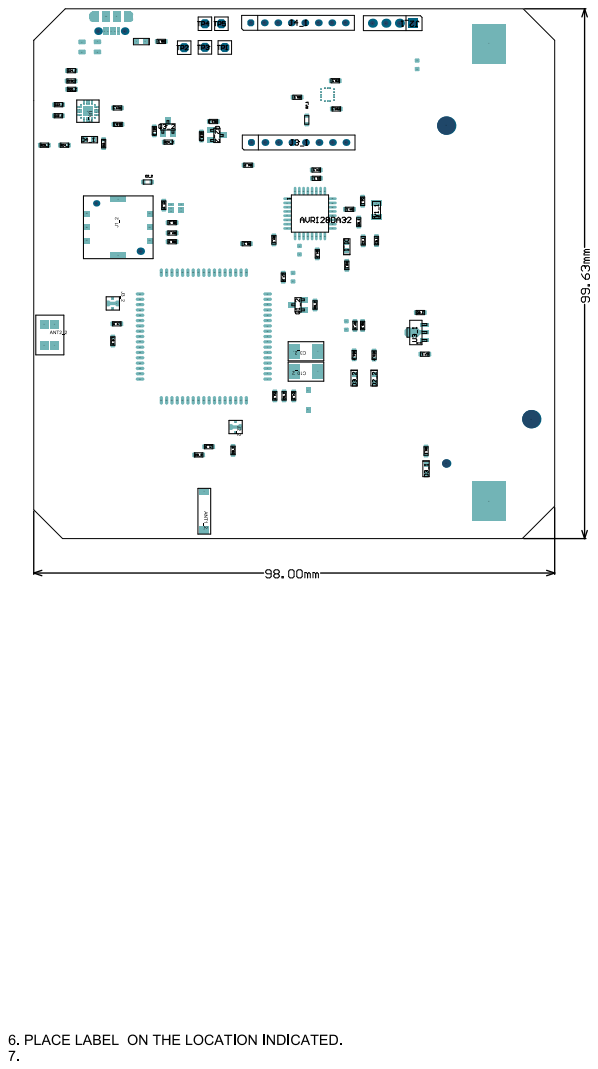
[picture p28: page 1]

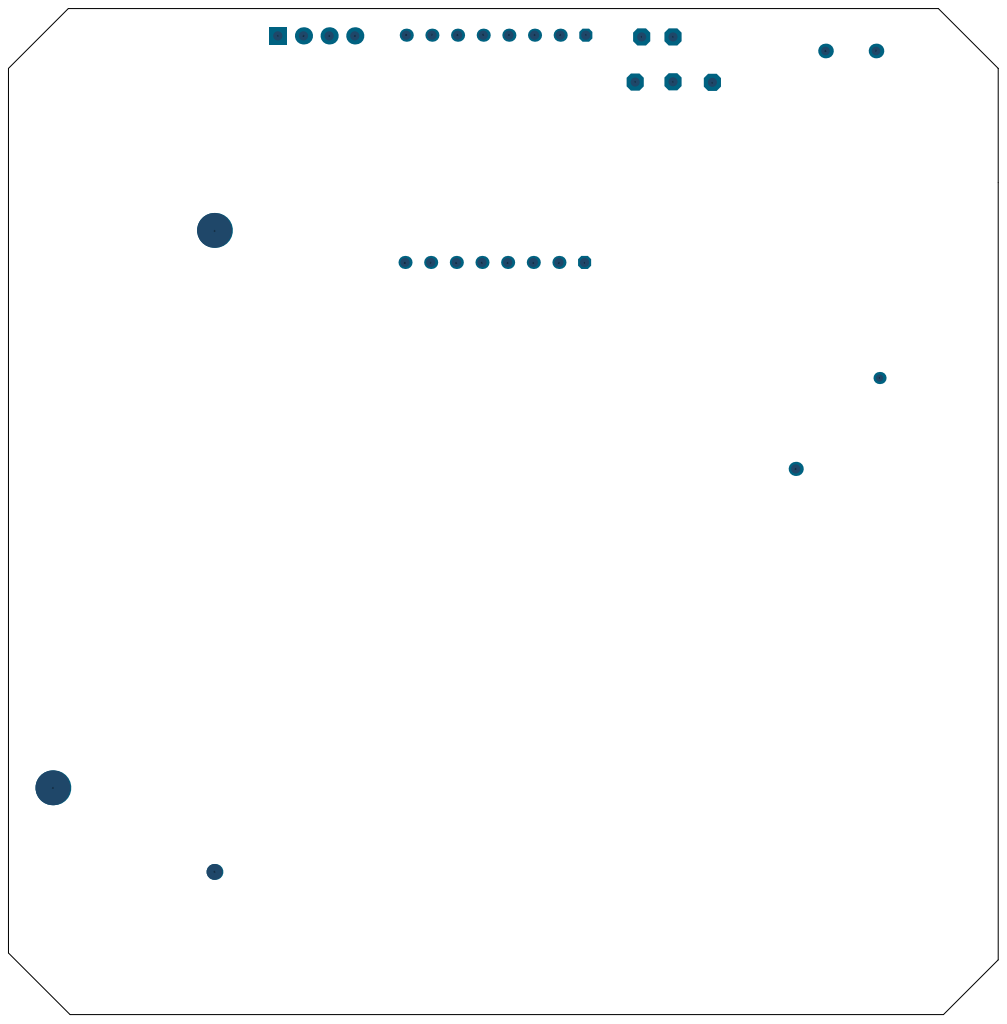
[picture p29: page 2]

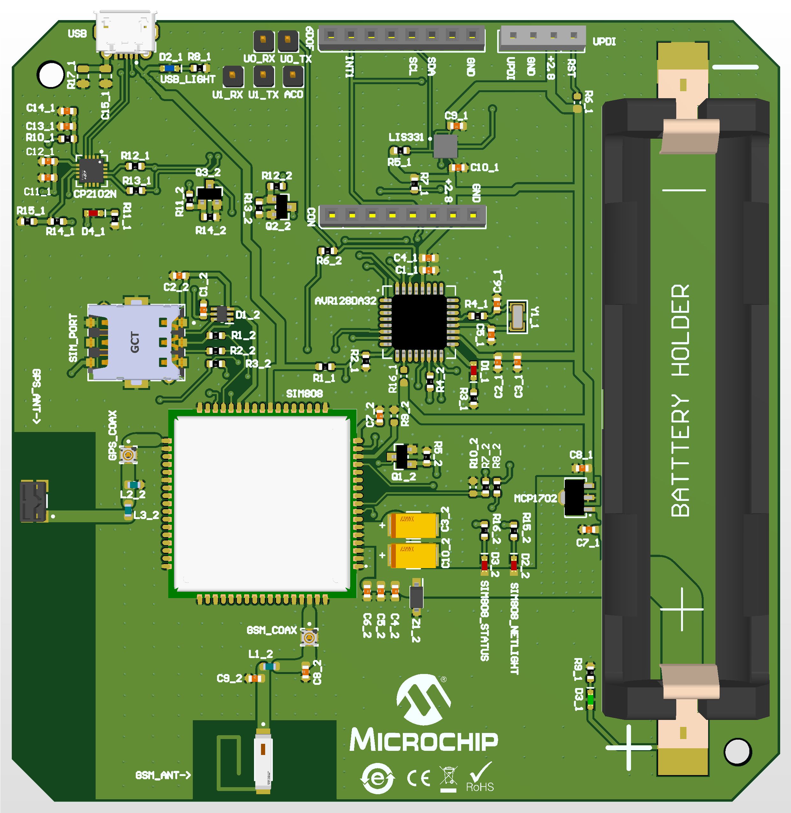
[picture p30: page 3]
