adrianntz/gpstracker/Hardware/Design/Project_Outputs/DevTools/04-ProjectPCBNumber-RProjectRevisionFAB-D.PDF

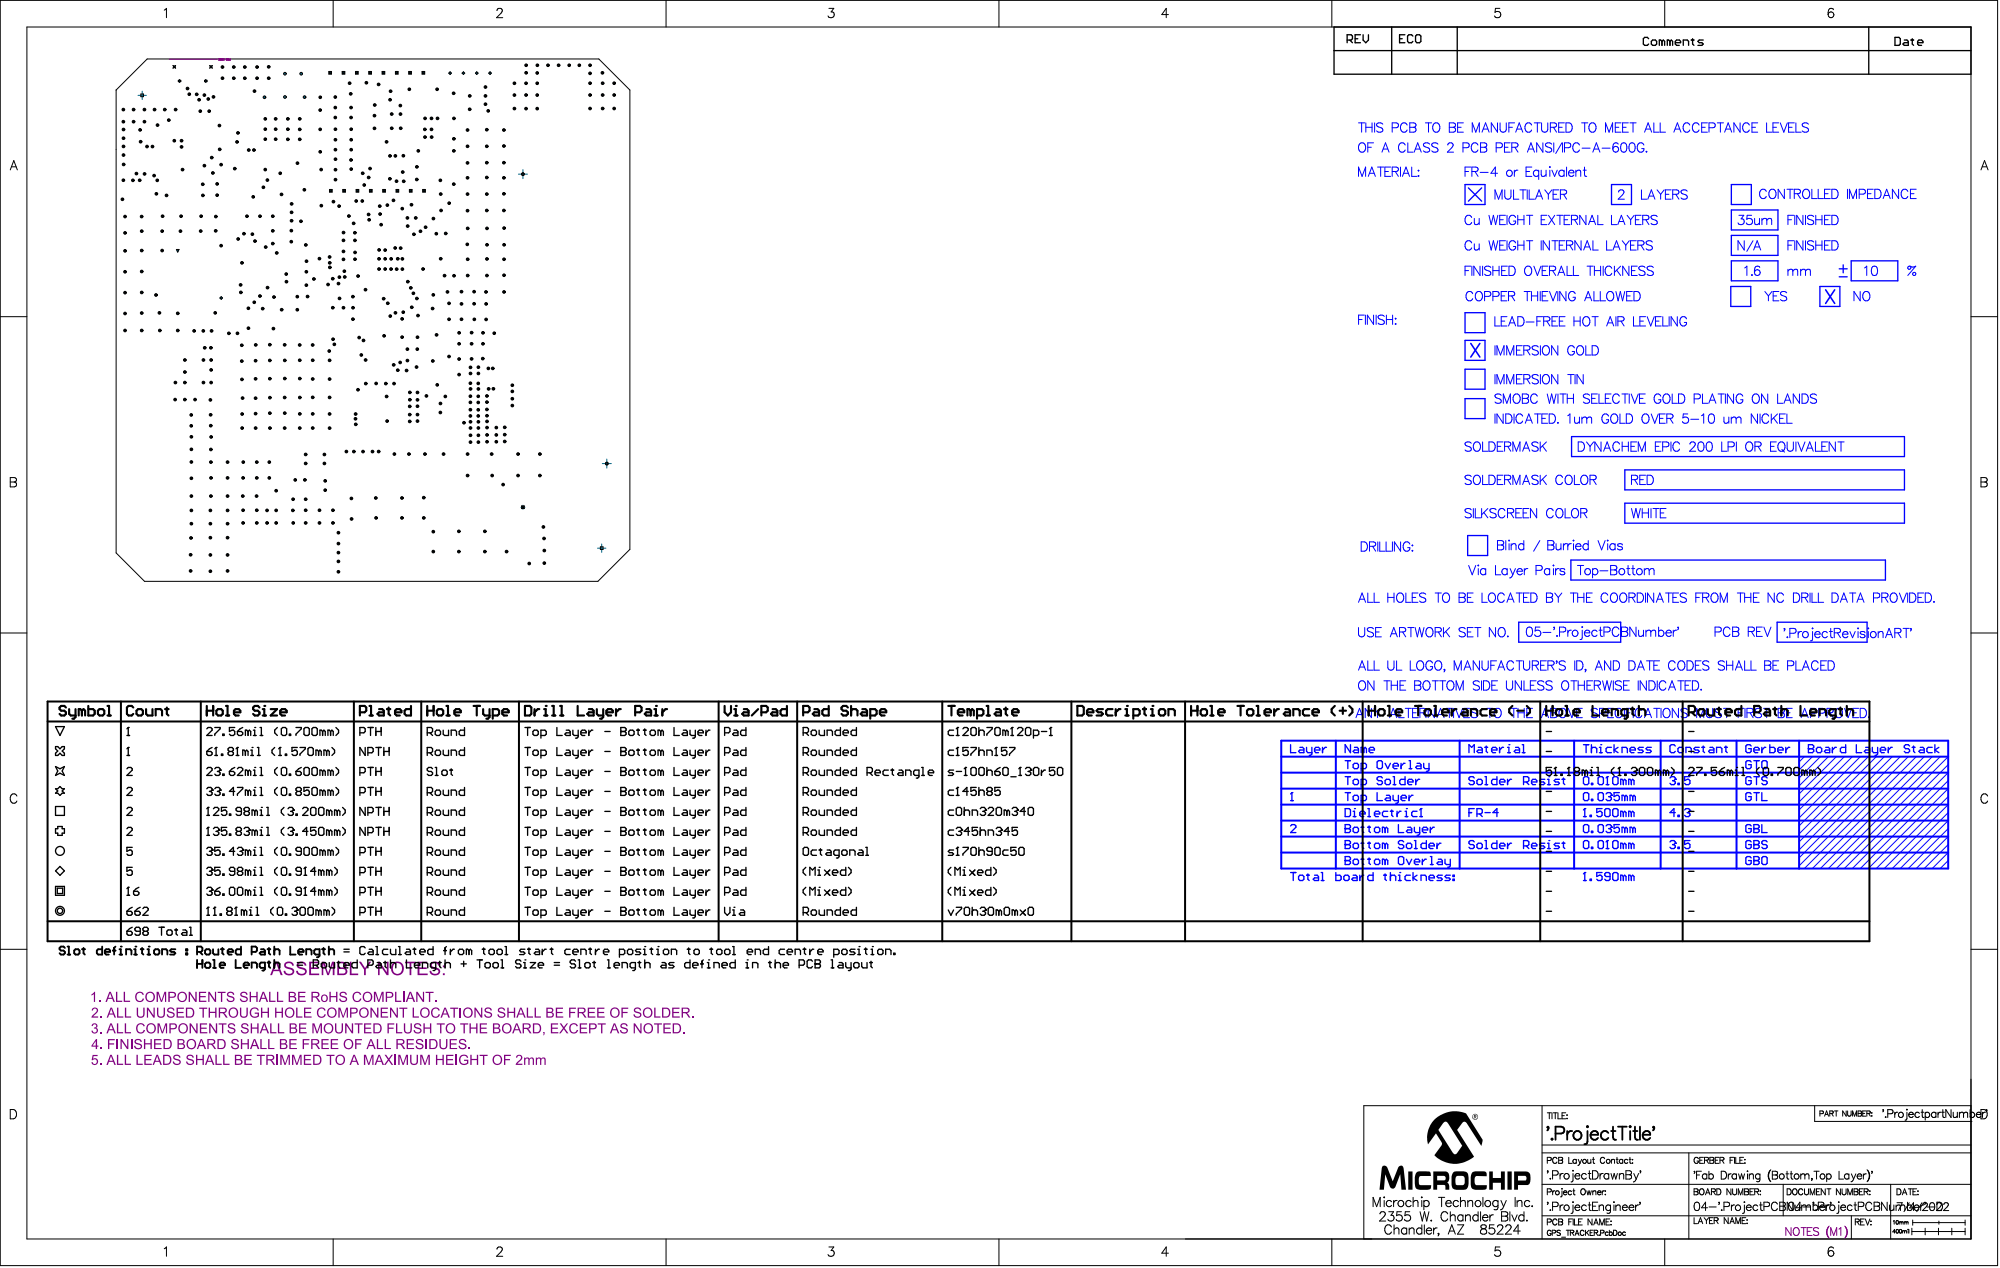
[picture p31: page 1]
