adrianntz/gpstracker/(list of files, drawings)

Other design files:
Hardware/Design/GPS_TRACKER.PrjPcb
Hardware/Design/MCU+Power_Supply+Accel.SchDoc
Hardware/Design/Project_Outputs/Webpage/ProjectPartNumber-RProjectRevisionASSY_Design_Files/GPS_TRACKER.PrjPcb
Hardware/Design/Project_Outputs/Webpage/ProjectPartNumber-RProjectRevisionASSY_Design_Files/MCU+Power_Supply+Accel.SchDoc
Hardware/Design/Project_Outputs/Webpage/ProjectPartNumber-RProjectRevisionASSY_Design_Files/SIM808+RF.SchDoc
Hardware/Design/SIM808+RF.SchDoc
