adrianntz/gpstracker/Firmware/Prototype Firmware/gps_tracker_rev.X/src/i2c.c

/*
    \file   i2c.c

    \brief  TWI I2C Driver

    (c) 2020 Microchip Technology Inc. and its subsidiaries.

    Subject to your compliance with these terms, you may use Microchip software and any
    derivatives exclusively with Microchip products. It is your responsibility to comply with third-party
    license terms applicable to your use of third-party software (including open source software) that
    may accompany Microchip software.

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
    IN NO EVENT WILL MICROCHIP BE LIABLE FOR ANY INDIRECT, SPECIAL, PUNITIVE,
    INCIDENTAL OR CONSEQUENTIAL LOSS, DAMAGE, COST OR EXPENSE OF ANY KIND
    WHATSOEVER RELATED TO THE SOFTWARE, HOWEVER CAUSED, EVEN IF MICROCHIP
    HAS BEEN ADVISED OF THE POSSIBILITY OR THE DAMAGES ARE FORESEEABLE. TO
    THE FULLEST EXTENT ALLOWED BY LAW, MICROCHIP'S TOTAL LIABILITY ON ALL
    CLAIMS IN ANY WAY RELATED TO THIS SOFTWARE WILL NOT EXCEED THE AMOUNT
    OF FEES, IF ANY, THAT YOU HAVE PAID DIRECTLY TO MICROCHIP FOR THIS
    SOFTWARE.
*/
#define F_CPU 4000000UL

#include <avr/io.h>

#include <util/delay.h>

#include <stdint.h>

#include <stdbool.h>

#include <stddef.h>

#include "../headers/i2c.h"

#ifdef TWI0_BAUD
#undef TWI0_BAUD
#endif

#define TWI0_BAUD(F_SCL, T_RISE)(uint8_t)((((((float) F_CPU / (float)(F_SCL)) - 10 - (((float)(F_CPU) * (T_RISE)) / 1000000.0))) / 2))

#define I2C_SCL_FREQ 100000 /* Frequency [Hz] */

enum {
  I2C_INIT = 0,
    I2C_ACKED,
    I2C_NACKED,
    I2C_READY,
    I2C_ERROR
};

void I2C_0_Init(void) 
{
  PORTC.DIRSET = PIN2_bm|PIN3_bm;
  PORTA.DIRSET = PIN2_bm|PIN3_bm;
  /* Select I2C pins PA2/PA3 */
  PORTMUX.TWIROUTEA = 0x00;

  /* Host Baud Rate Control */
  TWI0.MBAUD = TWI0_BAUD((I2C_SCL_FREQ), 0.3);

  /* Enable TWI */
  TWI0.MCTRLA = TWI_ENABLE_bm;

  /* Initialize the address register */
  TWI0.MADDR = 0x00;

  /* Initialize the data register */
  TWI0.MDATA = 0x00;

  /* Set bus state idle */
  TWI0.MSTATUS = TWI_BUSSTATE_IDLE_gc;
}

static uint8_t i2c_0_WaitW(void) {
  uint8_t state = I2C_INIT;
  do {
    if (TWI0.MSTATUS & (TWI_WIF_bm | TWI_RIF_bm)) {
      if (!(TWI0.MSTATUS & TWI_RXACK_bm)) {
        /* client responded with ack - TWI goes to M1 state */
        state = I2C_ACKED;
      } else {
        /* address sent but no ack received - TWI goes to M3 state */
        state = I2C_NACKED;
      }
    } else if (TWI0.MSTATUS & (TWI_BUSERR_bm | TWI_ARBLOST_bm)) {
      /* get here only in case of bus error or arbitration lost - M4 state */
      state = I2C_ERROR;
    }
  } while (!state);

  return state;
}

static uint8_t i2c_0_WaitR(void) {
  uint8_t state = I2C_INIT;

  do {
    if (TWI0.MSTATUS & (TWI_WIF_bm | TWI_RIF_bm)) {
      state = I2C_READY;
    } else if (TWI0.MSTATUS & (TWI_BUSERR_bm | TWI_ARBLOST_bm)) {
      /* get here only in case of bus error or arbitration lost - M4 state */
      state = I2C_ERROR;
    }
  } while (!state);

  return state;
}

/* Returns how many bytes have been sent, -1 means NACK at address, 0 means client ACKed to client address */
int I2C_0_SendData(uint8_t address, uint8_t * pData, uint8_t len) {
  int retVal = -1;

  /* start transmitting the client address */
  TWI0.MADDR = address & ~0x01;
  if (i2c_0_WaitW() != I2C_ACKED)
    return retVal;

  retVal = 0;
  if ((len != 0) && (pData != NULL)) {
    while (len--) {
      TWI0.MDATA = * pData;
      if (i2c_0_WaitW() == I2C_ACKED) {
        retVal++;
        pData++;
        continue;
      } else // did not get ACK after client address
      {
        break;
      }
    }
  }

  return retVal;
}

/* Returns how many bytes have been received, -1 means NACK at address */
int I2C_0_GetData(uint8_t address, uint8_t * pData, uint8_t len) {
  int retVal = -1;

  /* start transmitting the client address */
  TWI0.MADDR = address | 0x01;
  if (i2c_0_WaitW() != I2C_ACKED)
    return retVal;

  retVal = 0;
  if ((len != 0) && (pData != NULL)) {
    while (len--) {
      if (i2c_0_WaitR() == I2C_READY) {
        * pData = TWI0.MDATA;
        TWI0.MCTRLB = (len == 0) ? TWI_ACKACT_bm | TWI_MCMD_STOP_gc : TWI_MCMD_RECVTRANS_gc;
        retVal++;
        pData++;
        continue;
      } else
        break;
    }
  }

  return retVal;
}
