adrianntz/gpstracker/(commit log)

2022-03-24 Added prototype versions of SW Flowchart and HW Block schematic. Added GSM communication bring-up documentation and Project presentation as well
2022-05-05 MCU8APPS-52247: -Updated project dependancy on bare-metal written drivers. All drivers are now configured using MCC, making the code more easily portable -NMEAParser is rewritten using a much simpler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
    [GPS_TRACKER.PrjPcb, GPS_TRACKER_PROTOTYPE_SCHEMATIC.SchDoc, PCB1.PcbDoc]
2022-05-13 MCU8APPS-52251: Developed Initial Schematics for the GPS tracker pcb circuit.
    [GPS_TRACKER.PrjPcb, GPS_TRACKER_PROTOTYPE_SCHEMATIC.SchDoc, MCU+Power_Supply+Accel.SchDoc, SIM808+RF.SchDoc]
2022-05-16 MCU8APPS-52252: Updated Hardware Schematic to a preliminary state. Added preferences template to Altium from Microchip repo. This way all pcb preferences are in line with pcbway manufacturing capabil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
    [GPS_TRACKER.PcbDoc, GPS_TRACKER.PrjPcb, MCU+Power_Supply+Accel.SchDoc, PCB1.PcbDoc, SIM808+RF.SchDoc]
2022-05-26 MCU8APPS-52252: REV1: -Implemented existing Microchip PCB Template in order to comply with pcbway's manufacturing capabilities. -Redesigned the RESET pin circuitry for the MCP2221 chip in order for i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
    [GPS_TRACKER.PcbDoc, GPS_TRACKER.PrjPcb, MCU+Power_Supply+Accel.SchDoc, SIM808+RF.SchDoc]
2022-05-30 MCU8APPS-52252: Added 2nd revison to the preliminary schematic: -Replaced MIC5504 regulator with MCP1702T with 2.8V output. -Added LED power indicators for the USB and battery power lines. Also added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
    -Updated Filtering and crystal capacitor values for it to be similar to MIC2221 and AVR64DD32 breakout boards.
    -Updated BMI160 header pins to be compatible with mikroBUS breakout board.
    -All NPN transistor switching circuits were changed to NMOS switching circuits.
    -SIM808 UART lines series resistor were change with zero ohms shunts, and changed the voltage dividers to be DNP(Do not populated).
    [GPS_TRACKER.PrjPcb, MCU+Power_Supply+Accel.SchDoc, SIM808+RF.SchDoc]
2022-06-03 MCU8APPS-52252: REV3: Selected Components that are currently in stock and reselected components in schematic. MCP2221 USB to UART converter is not in stock, and shall be replaced. Notable replacement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
    [GPS_TRACKER.PrjPcb, MCU+Power_Supply+Accel.SchDoc, SIM808+RF.SchDoc]
2022-06-16 MCU8APPS-52252: REV4: Added PCB Layout files for prototype layout.
    [GPS_TRACKER.PrjPcb, GPS_TRACKER_BOM.xlsx, MCU+Power_Supply+Accel.SchDoc, SIM808+RF.SchDoc]
2022-06-16 Small revision to PCB Layout
    [GPS_TRACKER.PrjPcb, MCU+Power_Supply+Accel.SchDoc, SIM808+RF.SchDoc]
2022-06-20 Revision to PCB Layout component placement in order to optimize RF section.
    [MCU+Power_Supply+Accel.SchDoc, SIM808+RF.SchDoc]
2022-06-22 PCB REV: Small revisions to RF section in order to guarantee RF signal integrity by adding smaller vias, coplanar waves trace impedance matching and adjusting GND plane sizes.
    [SIM808+RF.SchDoc]
2022-06-22 PCB REV: Repositioned components to allow for a better high current return path in the bottom GND Plane
    [SIM808+RF.SchDoc]
2022-06-27 PCB REV 2: Added 2nd mounting hole to PCB board
2022-06-28 PCB REV 3: Changed uC from AVR64DD32 to AVR128DA32 due to stock shortage. Added Gerber Files to Project Output
    [GPS_TRACKER.PrjPcb, MCU+Power_Supply+Accel.SchDoc]
2022-06-29 Final PCB Rev: Reduced RF emissions and improved LDO heat dissipation. Other fixes.
    [GPS_TRACKER.PrjPcb, MCU+Power_Supply+Accel.SchDoc]
2022-07-04 BB Repository Hardware Section Clean up
    [02-ProjectPCBAssyNumber-RProjectRevisionASSY_BOM.xls, GPS_TRACKER.PrjPcb, GPS_TRACKER_BOM.xlsx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]
2022-07-04 PCB FINAL REV 2
    [05-ProjectPCBNumber-RProjectRevisionART.GBL, 05-ProjectPCBNumber-RProjectRevisionART.GBS, 05-ProjectPCBNumber-RProjectRevisionART.GTL, 05-ProjectPCBNumber-RProjectRevisionART.GTO, 05-ProjectPCBNumber-RProjectRevisionART.GTS]
2022-07-04 Manufacturing Files 04.07.2022
    [02-ProjectPCBAssyNumber-RProjectRevisionASSY_BOM.xls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]
2022-07-04 Manufacturing Files edit 04.07.2022
    [02-ProjectPCBAssyNumber-RProjectRevisionASSY_BOM.xls]
2022-07-07 Firmware Updated: Added VBUS check feature, which disables the debug USART transmission when the VBUS port is not connected. However, the USART module couldn't be restarted without the peripheric not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
    [BMI160_INIT.c, i2c.c, main.c]
2022-07-11 FIRMWARE: Added Firmware MPLAB Project for the AVR128DA32 configuration for the PCB
2022-07-11 FIRMWARE: Corrected comments on TWI0 bare-metal driver
    [i2c.c]
2022-07-12 Host Software: Added a new homepage using HTML with Bootstrap CSS.
    [generator_config.txt]
2022-07-13 FIRMWARE Update: Fixed USART reset bug where it would not turn on after it was previously shut down. Fixed it for both Break-out-board firmware and PCB firmware
    [i2c.c, main.c]
2022-07-15 Host Website Software: Added missing files that were not added in the previous commit.
    [generator_config.txt]
2022-07-18 Host Web Software: Added an auto-deleting old markers (Marker limit is at 30, can be changed) on the Map to avoid over crowding with markers which may slow down the website. Also added a toggle-switc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
2022-07-22 Firmware update: Added small bug fixes (The SIM808 module will not be placed to sleep while the USB Cable is connected to allow it to charge the battery, added small LED blinking to indicate when the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
    [BMI160_INIT.c, i2c.c, main.c]
2022-07-26 Firmware and Host Website Software Update: Added small updates to the PCB Firmware and migrated the Host Website to AWS Services, having the first fully functional build.
2022-07-27 Firmware And Host Software: Added Battery Level Indicator functionality on the website, the battery level being sent out through GPRS. Also improvede energy savings by turning off the SIM808 module c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
2022-07-29 Host Software and Firmware: Fixed hosted website software bug where all markers would all have the same data. Added battery info on every marker. FIrmware has been updated to have lower number of tra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
    [main.c]
